copl-labomc/fabconcept/Fiber_Drawing_Tower/Electronics/fiber_electronics_reference_1.jpg

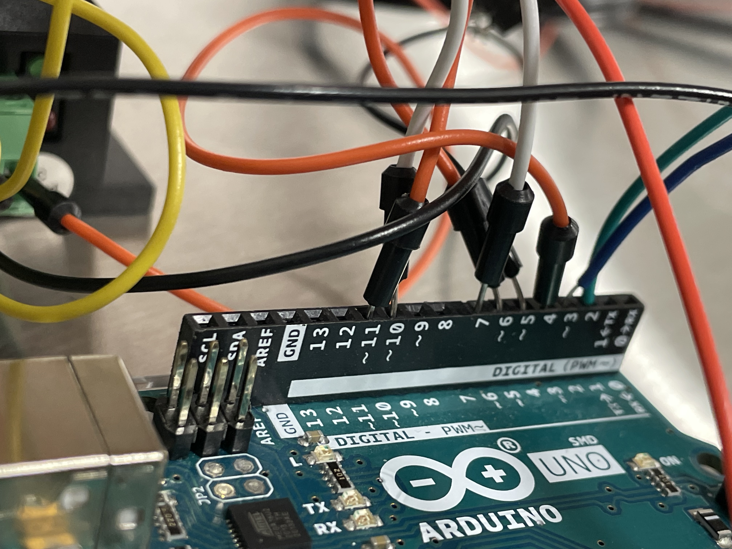
Fiber_Drawing_Tower/Electronics/fiber_electronics_reference_1.jpg
