copl-labomc/fabconcept/Fiber_Drawing_Tower/Electronics/fiber_electronics_reference_2.jpg

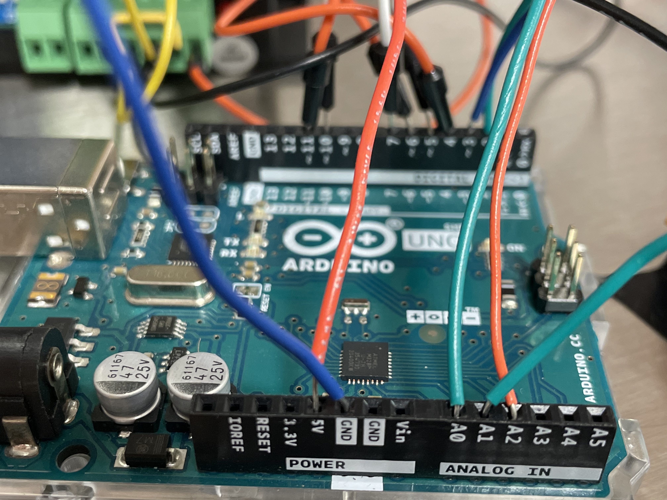
Fiber_Drawing_Tower/Electronics/fiber_electronics_reference_2.jpg
