copl-labomc/fabconcept/README.md

# fabconcept #
Making, modeling and simulating materials doped with nanosemiconductors as well as drawing them into optical fibers.

For more information, see the [wiki](https://github.com/copl-labomc/fabconcept/wiki).
