copl-labomc/fabconcept/Fiber_Drawing_Tower/diagramme_fonctionnel_tour.pptx

Preform stepper motor

Stepper motor driver

Speed command

Capstan stepper motor

Stepper motor driver

Arduino Uno

Spool stepper motor

Stepper motor driver

Laser sensor

Fiber diameter

Config data
Start/Stop commands
Diameter command

Real T°

Laptop
GUI

Motor speeds
Fiber diameter

Furnace

Thermocouple +
PID

T° setpoint
