copl-labomc/fabconcept/Fiber_Drawing_Tower/Archives/Été_2023/Concept_GUI.xlsx

 |  |  |  | Name of the file |  | .txt
 | Graphique |  |  | Speed of motor |  | m/s
 | PID
 |  | Apply | Diameter | Diameter |  | mm
 |  |  |  | Length |  | m
Représentaion imager de la fibre
 |  |  |  |  | Start
Ajuster l'échelle
