copl-labomc/fabconcept/Fiber_Drawing_Tower/Arduino_and_Python_code/Github flowchart for software development.PNG

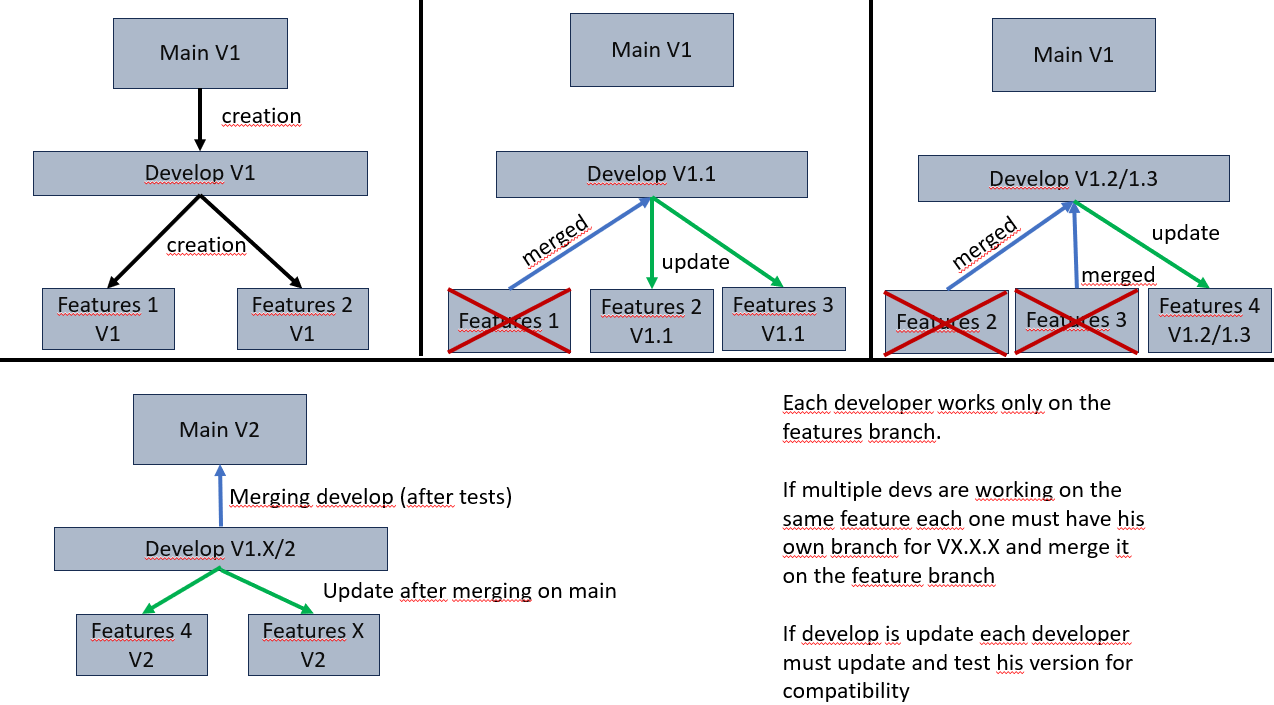
Fiber_Drawing_Tower/Arduino_and_Python_code/Github flowchart for software development.PNG
