copl-labomc/fabconcept/Fiber_Drawing_Tower/Diagramme fonctionnel.png

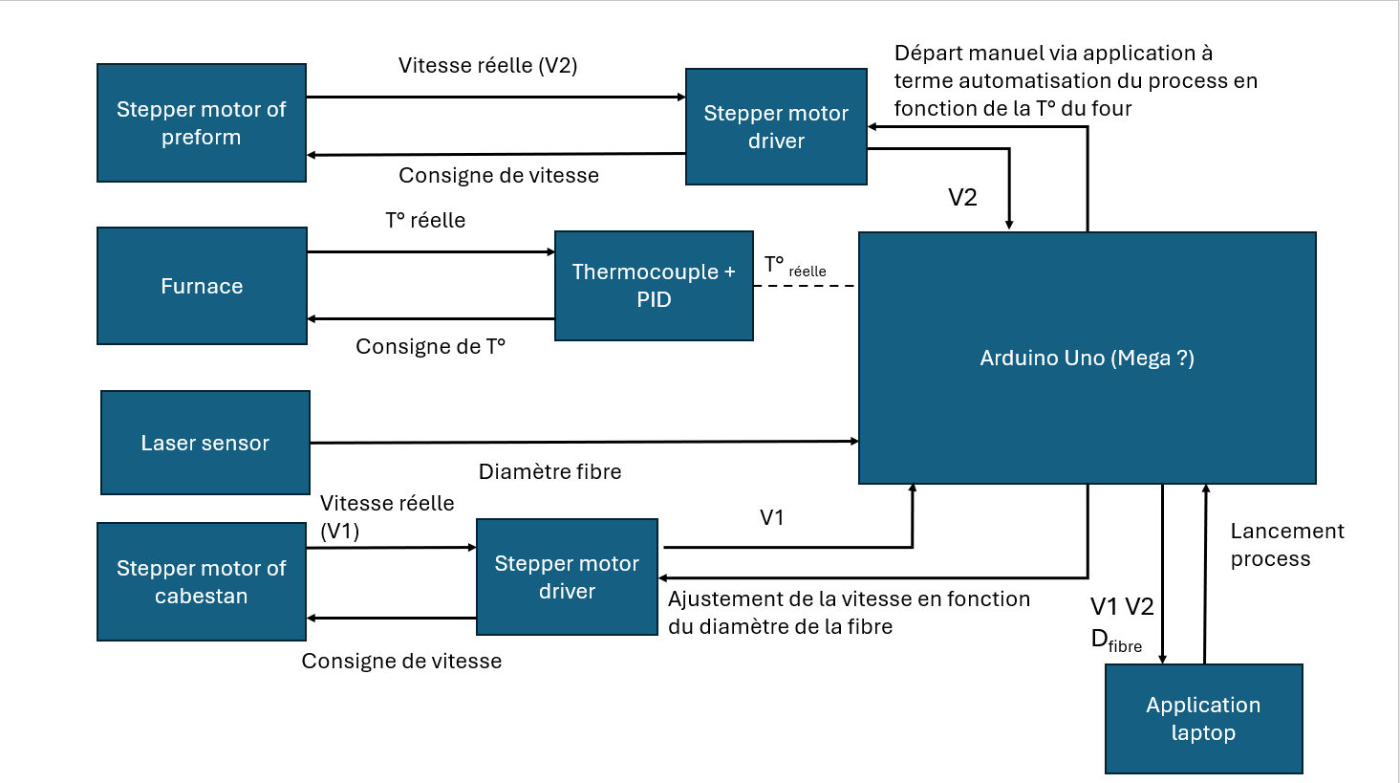
Fiber_Drawing_Tower/Diagramme fonctionnel.png
