copl-labomc/fabconcept/Fiber_Drawing_Tower/Electronics/Fiber_tower_circuit_schéma.png

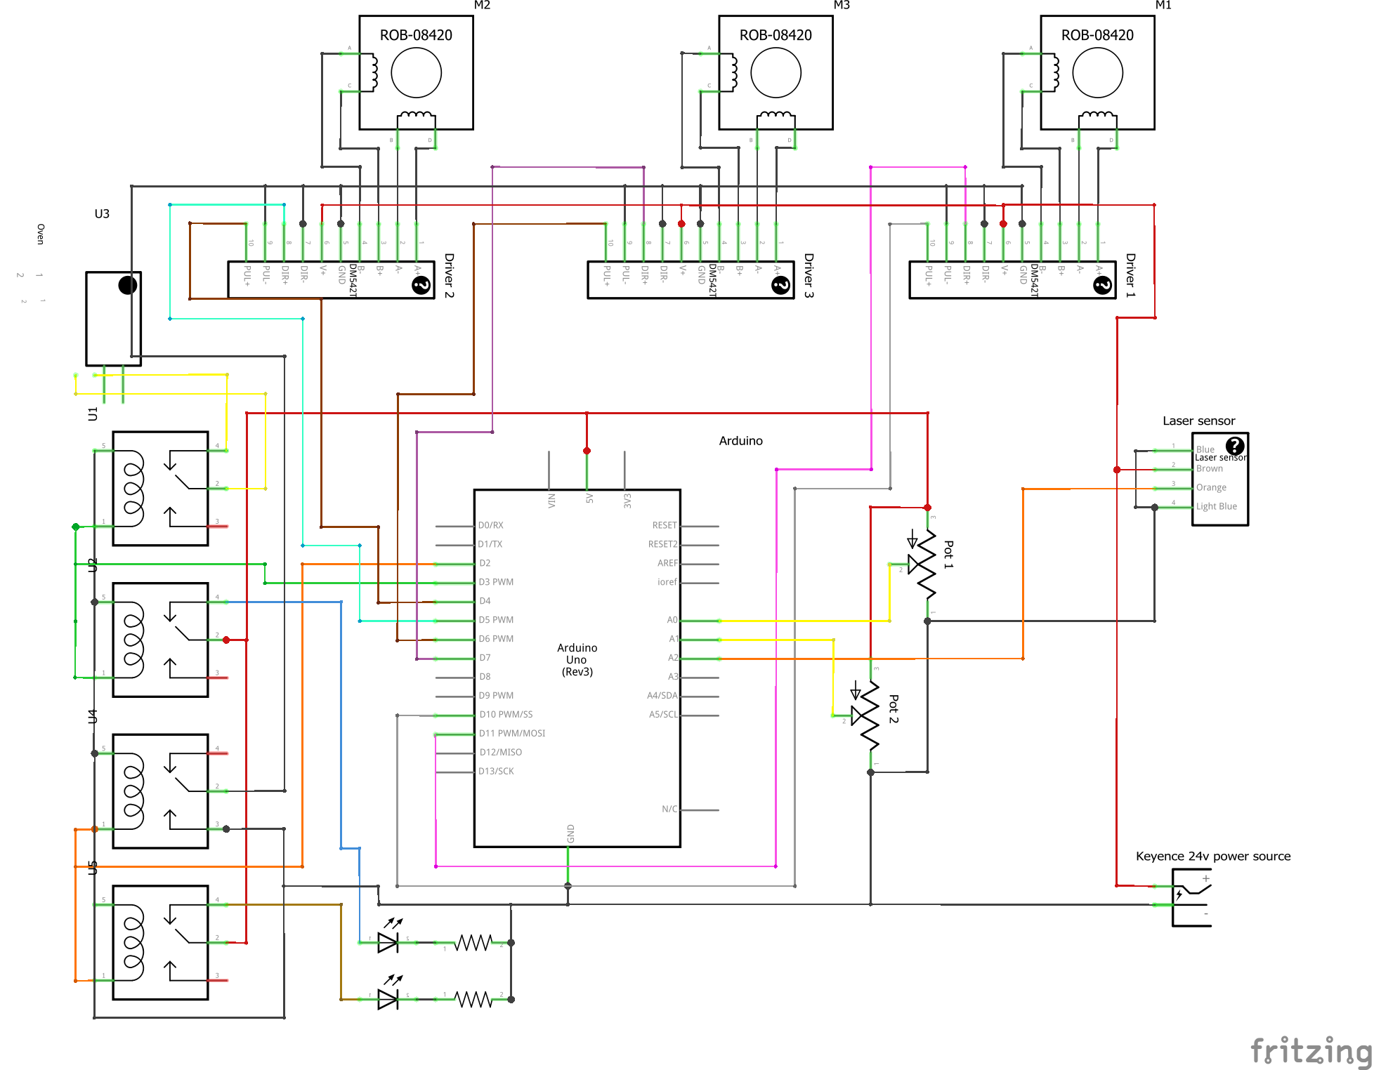
Fiber_Drawing_Tower/Electronics/Fiber_tower_circuit_schéma.png
