copl-labomc/fabconcept/Molecular_Dynamics_Simulations/coordinates.gif

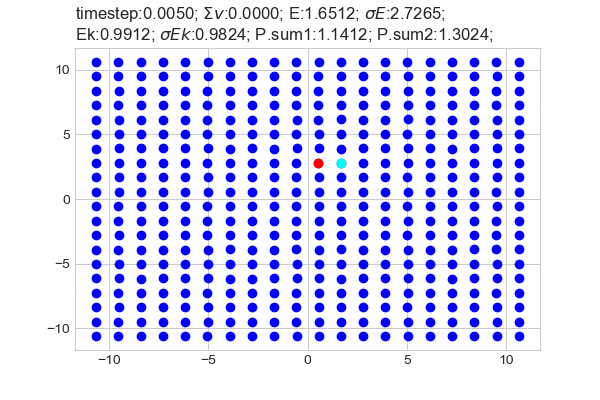
Molecular_Dynamics_Simulations/coordinates.gif
