copl-labomc/fabconcept/Fiber_Drawing_Tower/CAD_sketches/Automatic spool/Current design/Spool_holder.SLDASM

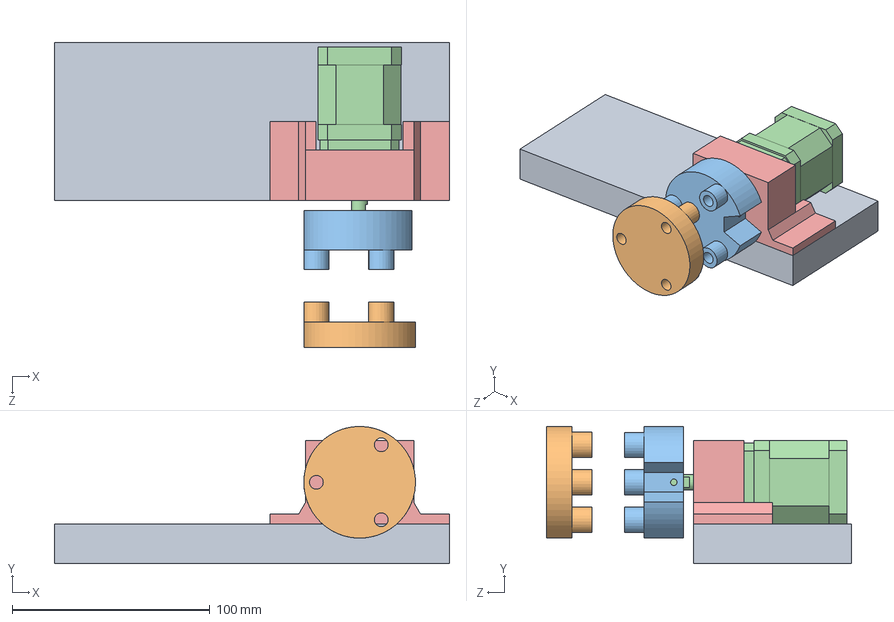
[picture p7: CAD file, 2025-07-08]
Fiber_Drawing_Tower/CAD_sketches/Automatic spool/Current design/Spool_holder.SLDASM
200.0 x 69.4 x 154.5 mm
Fixation_moteur
17HS19-1684S-PG5
coupler_motor_side
coupler_other_side
Spool_support
