copl-labomc/fabconcept/Fiber_Drawing_Tower/CAD_sketches/Preform holder Didn't work/Preform holder.SLDASM

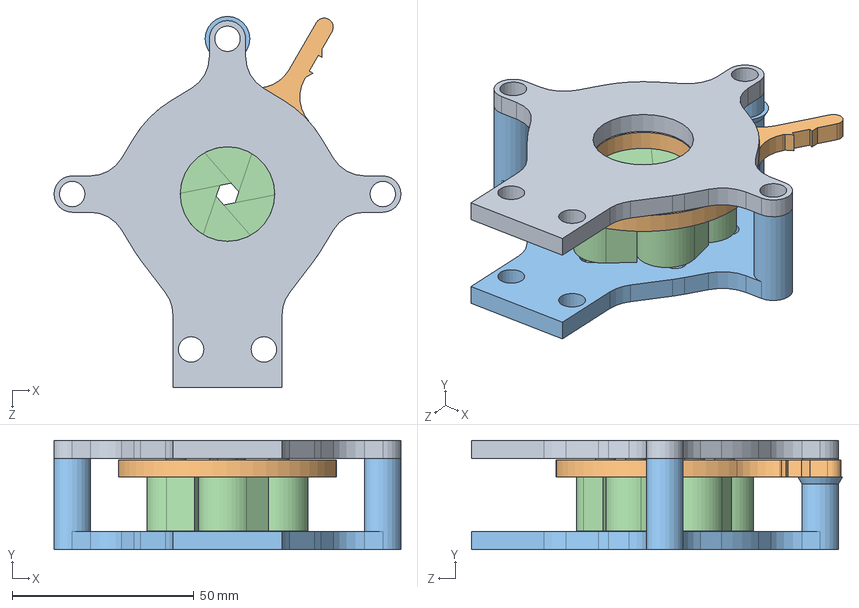
[picture p8: CAD file, 2025-07-08]
Fiber_Drawing_Tower/CAD_sketches/Preform holder Didn't work/Preform holder.SLDASM
95.3 x 30.0 x 102.0 mm
dent x 6
Base 1
Glisseur
Couvercle
