copl-labomc/fabconcept/Fiber_Drawing_Tower/CAD_sketches/Capstan 2.0/Capstan 2.0.SLDASM

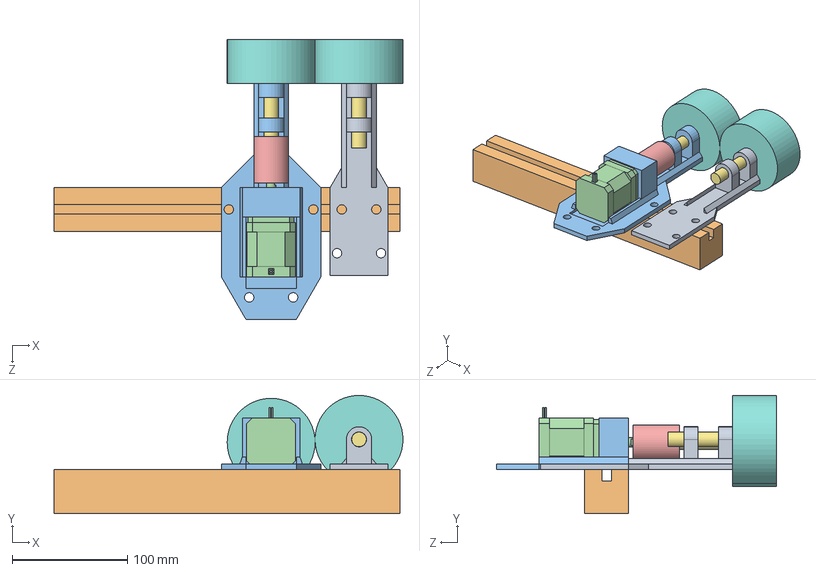
[picture p9: CAD file, 2025-07-08]
Fiber_Drawing_Tower/CAD_sketches/Capstan 2.0/Capstan 2.0.SLDASM
302.4 x 102.3 x 242.4 mm
Wheel x 2
Wheel shaft x 2
Bearing x 4
Motor coupler
17HS19-1684S-PG5
Base motor side
Support beam
Base other side
