copl-labomc/fabconcept/Fiber_Drawing_Tower/CAD_sketches/Preform holder 2 Just a concept/Gripper/Assembly1.stp

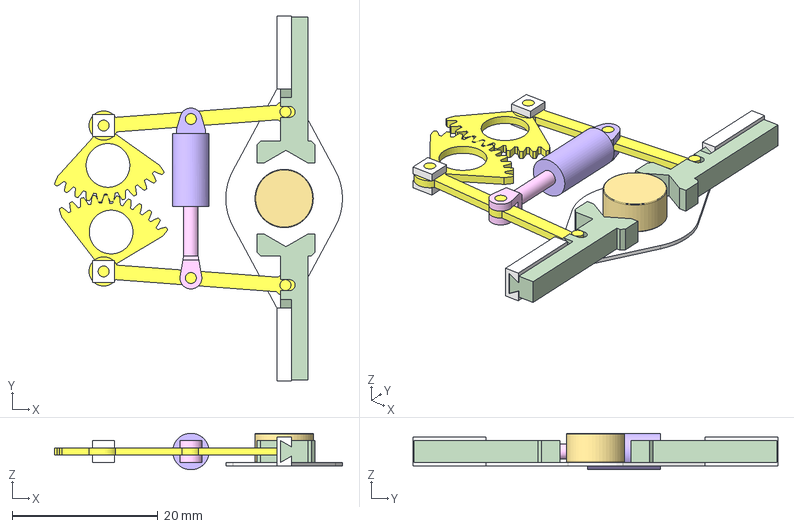
[picture p10: CAD file, 2025-07-08]
Fiber_Drawing_Tower/CAD_sketches/Preform holder 2 Just a concept/Gripper/Assembly1.stp
39.5 x 50.0 x 5.00 mm
Runway
Frame x 2
Jaw1 x 2
CrankA x 2
Gear x 2
Piston
Work
