copl-labomc/fabconcept/Fiber_Drawing_Tower/CAD_sketches/Fiber tower structure (2023)/Assemblage_3d V1.SLDASM

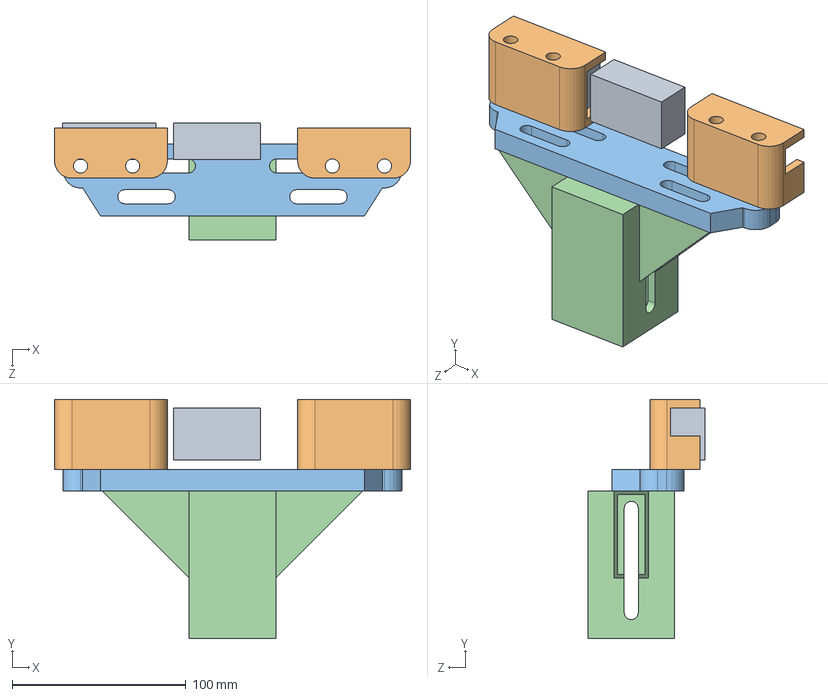
[picture p11: CAD file, 2024-05-07]
Fiber_Drawing_Tower/CAD_sketches/Fiber tower structure (2023)/Assemblage_3d V1.SLDASM
205.0 x 137.8 x 67.6 mm
jauge_diametre
support_jauge x 2
Piece_fixation
bras_jauge
