copl-labomc/fabconcept/Fiber_Drawing_Tower/CAD_sketches/Fiber tower structure (2023)/Assemblage V5.SLDASM

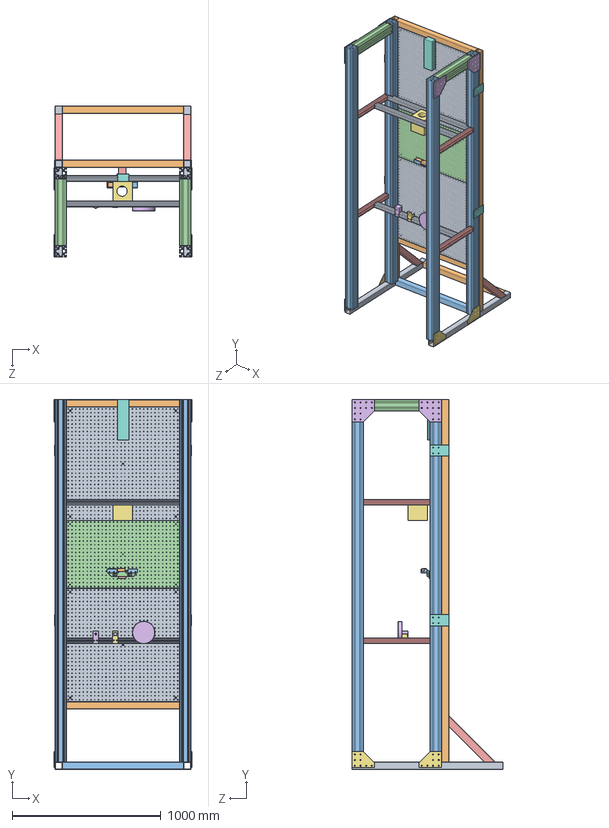
[picture p12: CAD file, 2024-05-07]
Fiber_Drawing_Tower/CAD_sketches/Fiber tower structure (2023)/Assemblage V5.SLDASM
927.1 x 2489.2 x 1016.0 mm
Low-Carbon Steel Tube 40 x 2
Low-Carbon Steel Tube 96 x 2
47065T609_T-Slotted Framing x 4
47065T608_ALUMINUM T-SLOTTED 17.725 x 2
Low-Carbon Steel Tube angle x 2
47065T277_T-Slotted Framing stock x 4
47065T277_T-Slotted Framing x 4
Plaque de fixation x 4
MB30-Solidworks x 2
Low-Carbon Steel Tube 32-1 x 3
Low-Carbon Steel Tube 32
MB1830-Solidworks (1)
47065T942_T-Slotted Framing_30in x 4
Fourneau
Feeder preforme
47065T602_T-Slotted Framing_36in x 3
jauge_diametre
support_jauge x 2
Piece_fixation
bras_jauge
Fixation Roue
Fixation moteur
