copl-labomc/fabconcept/Fiber_Drawing_Tower/CAD_sketches/Capstan 2.0/Bearing.SLDPRT

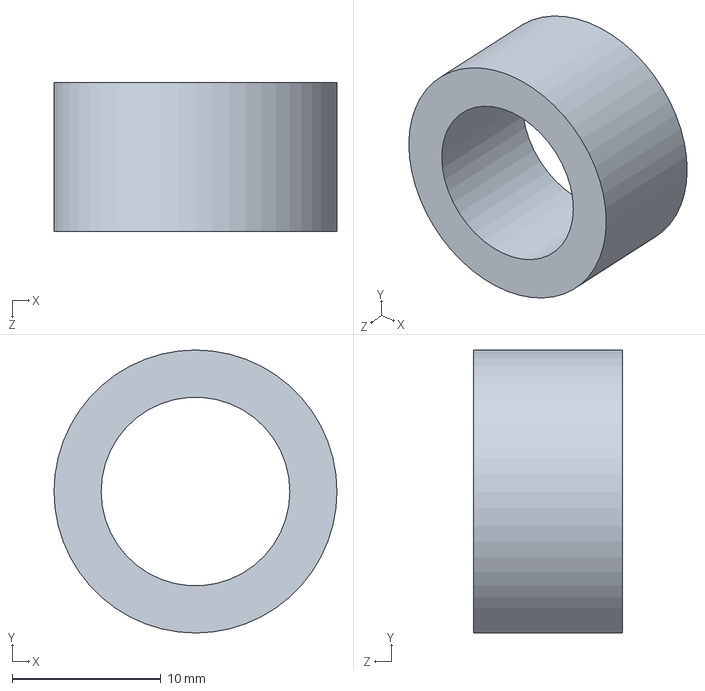
[picture p13: CAD file, 2025-07-08]
Fiber_Drawing_Tower/CAD_sketches/Capstan 2.0/Bearing.SLDPRT
19.1 x 19.1 x 10.0 mm
