copl-labomc/fabconcept/Fiber_Drawing_Tower/CAD_sketches/Fiber tower structure (2023)/Fourneau.SLDPRT

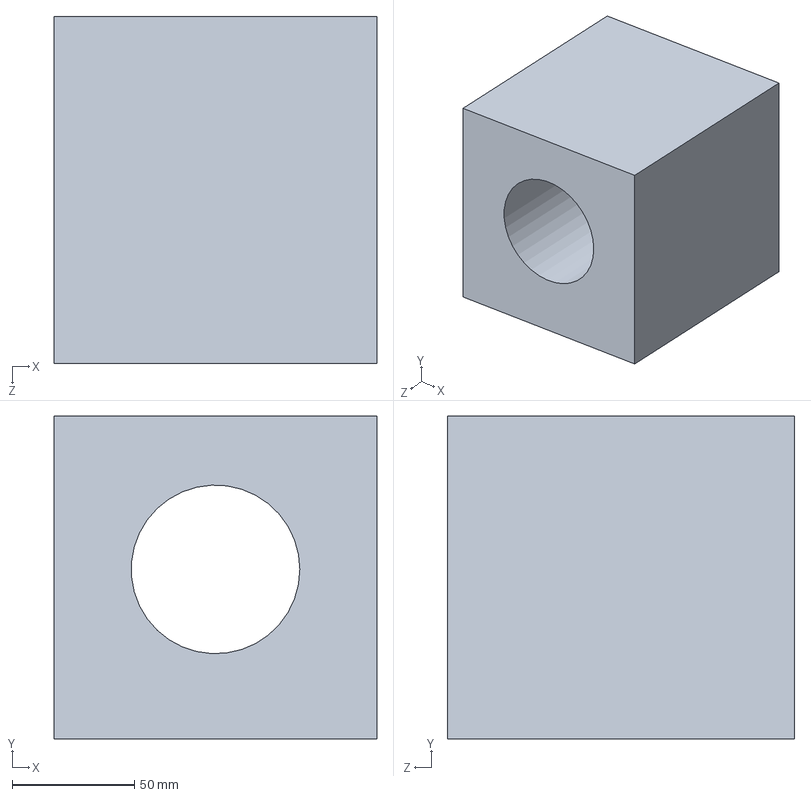
[picture p14: CAD file, 2024-05-07]
Fiber_Drawing_Tower/CAD_sketches/Fiber tower structure (2023)/Fourneau.SLDPRT
132.0 x 132.0 x 142.0 mm
