copl-labomc/fabconcept/Fiber_Drawing_Tower/CAD_sketches/holders laser sensor IG/holder_3D_impression.STL

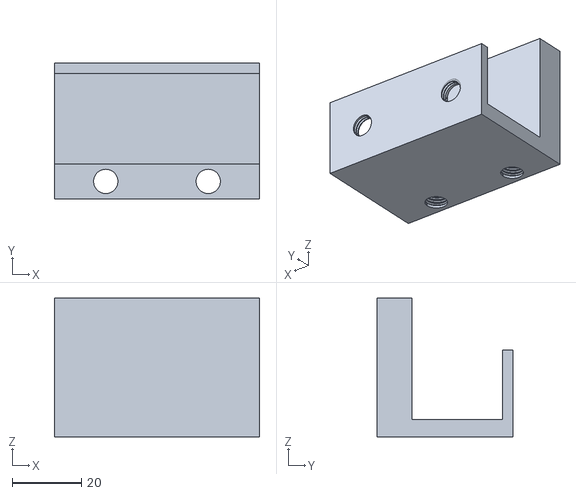
[picture p15: CAD file, 2024-05-31]
Fiber_Drawing_Tower/CAD_sketches/holders laser sensor IG/holder_3D_impression.STL
59.0 x 39.0 x 40.0
