copl-labomc/fabconcept/Fiber_Drawing_Tower/CAD_sketches/Preform holder 2 Just a concept/Gripper/Bearing.stp

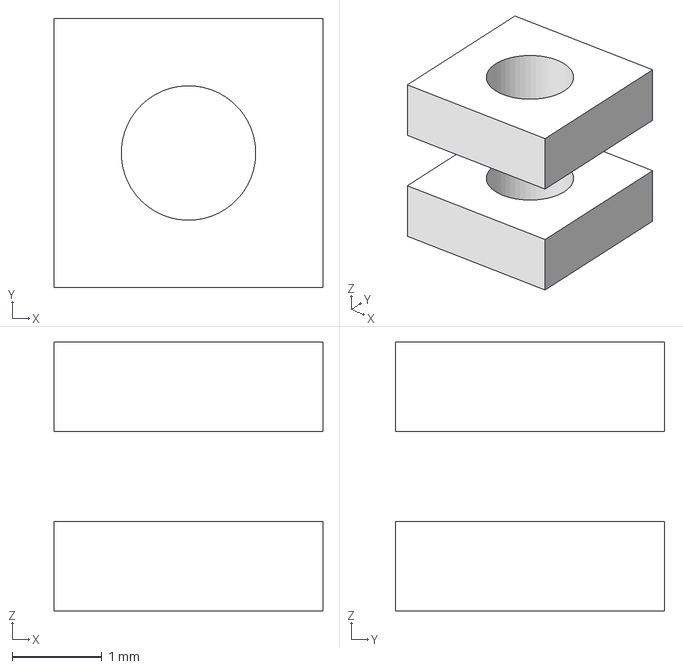
[picture p16: CAD file, 2025-07-08]
Fiber_Drawing_Tower/CAD_sketches/Preform holder 2 Just a concept/Gripper/Bearing.stp
3.00 x 3.00 x 3.00 mm
