copl-labomc/fabconcept/Fiber_Drawing_Tower/CAD_sketches/Preform holder 2 Just a concept/Newport variable lens holder/Newport-LCM-1.stp

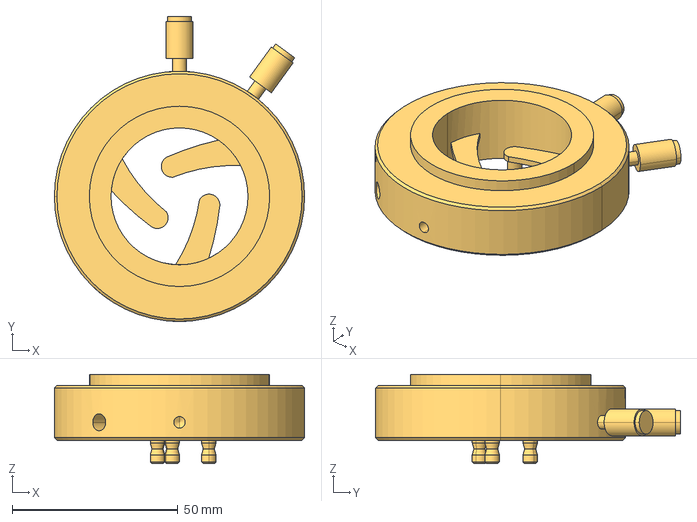
[picture p17: CAD file, 2025-07-08]
Fiber_Drawing_Tower/CAD_sketches/Preform holder 2 Just a concept/Newport variable lens holder/Newport-LCM-1.stp
75.4 x 91.9 x 26.9 mm
