copl-labomc/fabconcept/Fiber_Drawing_Tower/CAD_sketches/Preform holder 3.0 unfinished/Holder holder.SLDPRT

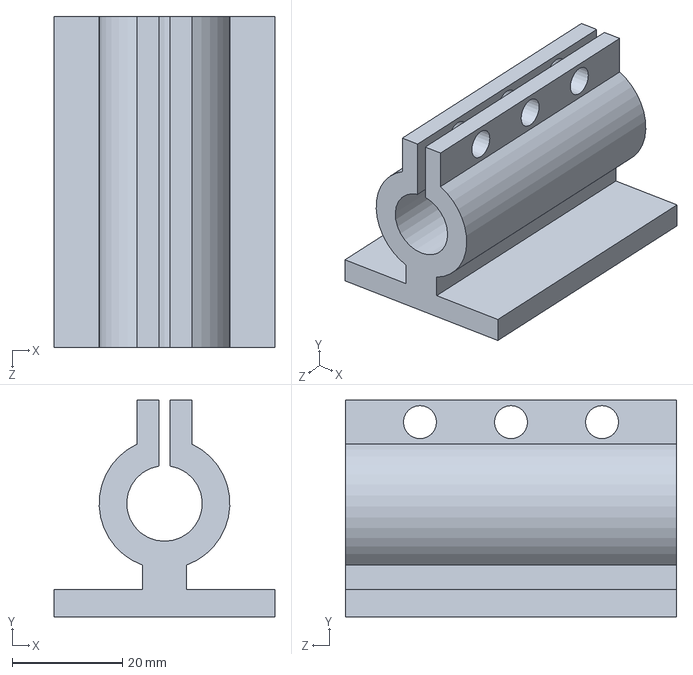
[picture p18: CAD file, 2025-07-08]
Fiber_Drawing_Tower/CAD_sketches/Preform holder 3.0 unfinished/Holder holder.SLDPRT
40.0 x 39.3 x 60.0 mm
