copl-labomc/fabconcept/Fiber_Drawing_Tower/CAD_sketches/Preform holder Didn't work/Base.STL

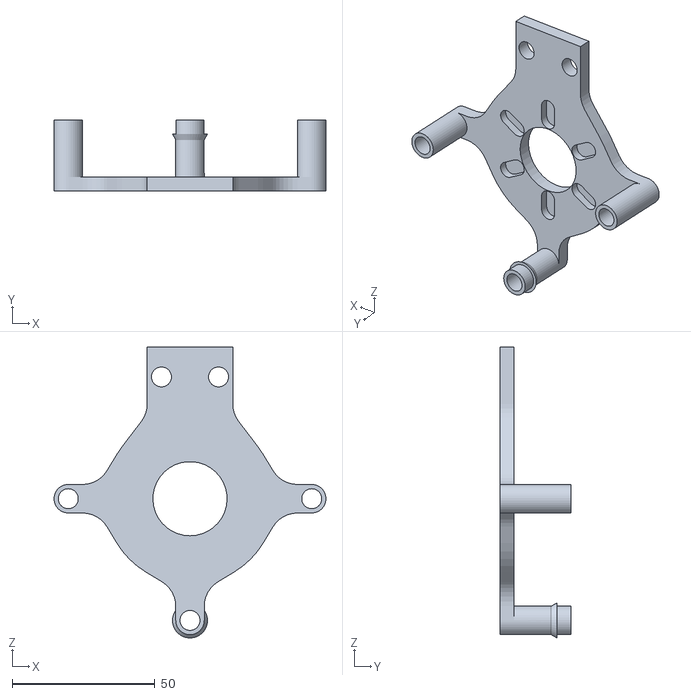
[picture p19: CAD file, 2025-07-08]
Fiber_Drawing_Tower/CAD_sketches/Preform holder Didn't work/Base.STL
95.3 x 25.0 x 102.0
