copl-labomc/fabconcept/Fiber_Drawing_Tower/CAD_sketches/Automatic spool/Current design/coupler_motor_side.SLDPRT

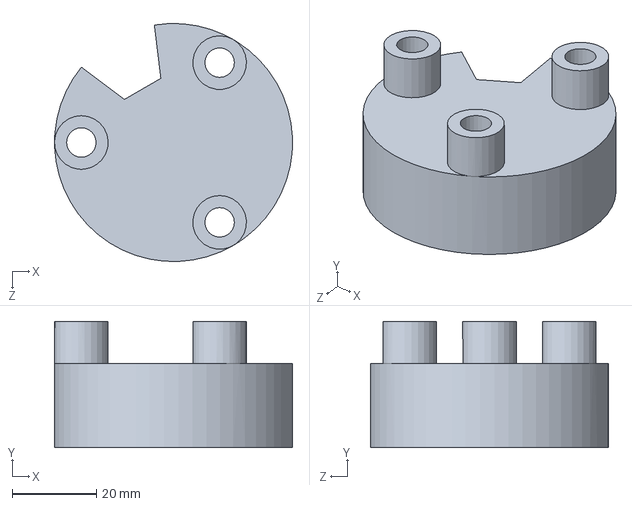
[picture p20: CAD file, 2025-07-08]
Fiber_Drawing_Tower/CAD_sketches/Automatic spool/Current design/coupler_motor_side.SLDPRT
56.5 x 30.0 x 56.5 mm
