copl-labomc/fabconcept/Fiber_Drawing_Tower/CAD_sketches/Capstan 2.0/Base 1.STL

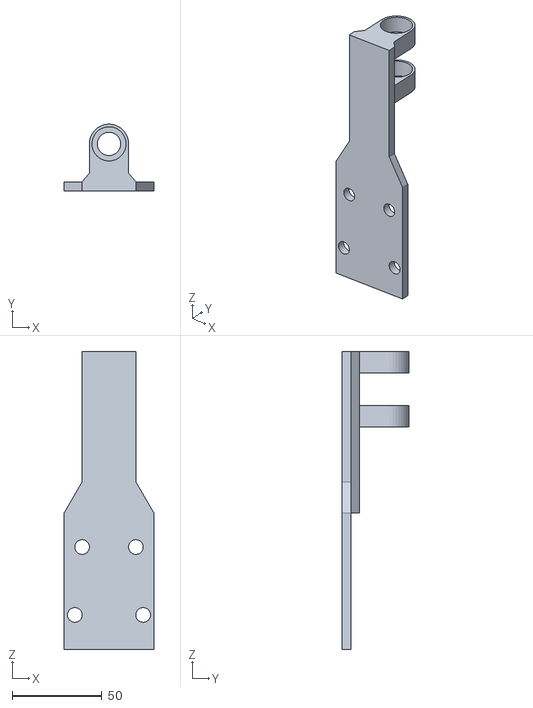
[picture p21: CAD file, 2025-07-08]
Fiber_Drawing_Tower/CAD_sketches/Capstan 2.0/Base 1.STL
50.0 x 37.1 x 166.2
