copl-labomc/fabconcept/Fiber_Drawing_Tower/CAD_sketches/Fiber tower structure (2023)/Feeder preforme.SLDPRT

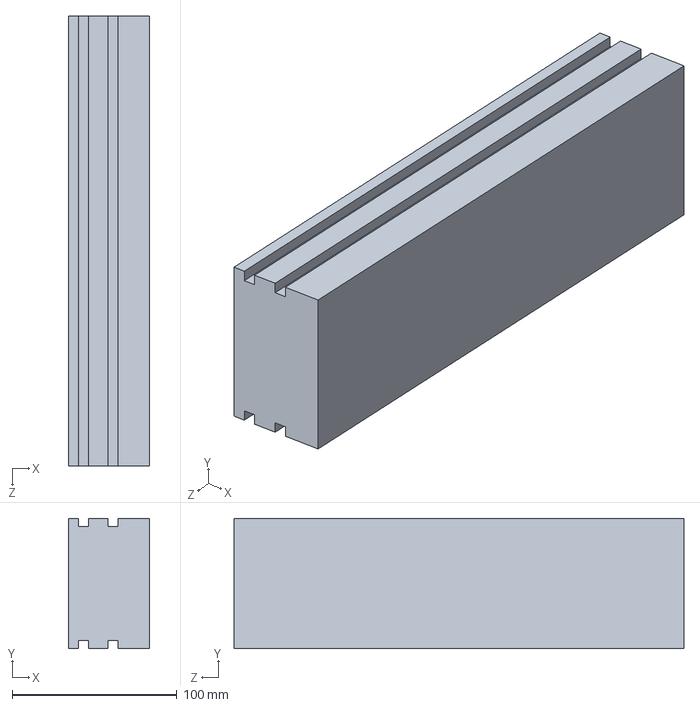
[picture p22: CAD file, 2024-05-07]
Fiber_Drawing_Tower/CAD_sketches/Fiber tower structure (2023)/Feeder preforme.SLDPRT
49.0 x 79.0 x 273.0 mm
