copl-labomc/fabconcept/Fiber_Drawing_Tower/CAD_sketches/Preform holder 2 Just a concept/Gripper/Gear.stp

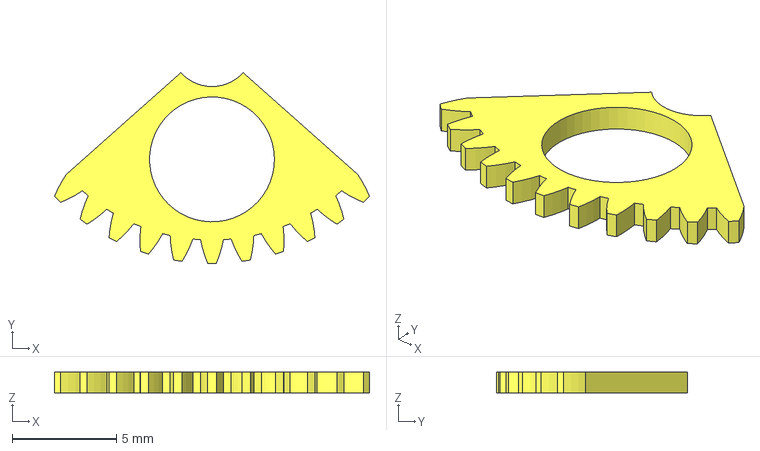
[picture p23: CAD file, 2025-07-08]
Fiber_Drawing_Tower/CAD_sketches/Preform holder 2 Just a concept/Gripper/Gear.stp
15.1 x 9.17 x 1.00 mm
