copl-labomc/fabconcept/Fiber_Drawing_Tower/CAD_sketches/Automatic spool/Current design/Spool_support.SLDPRT

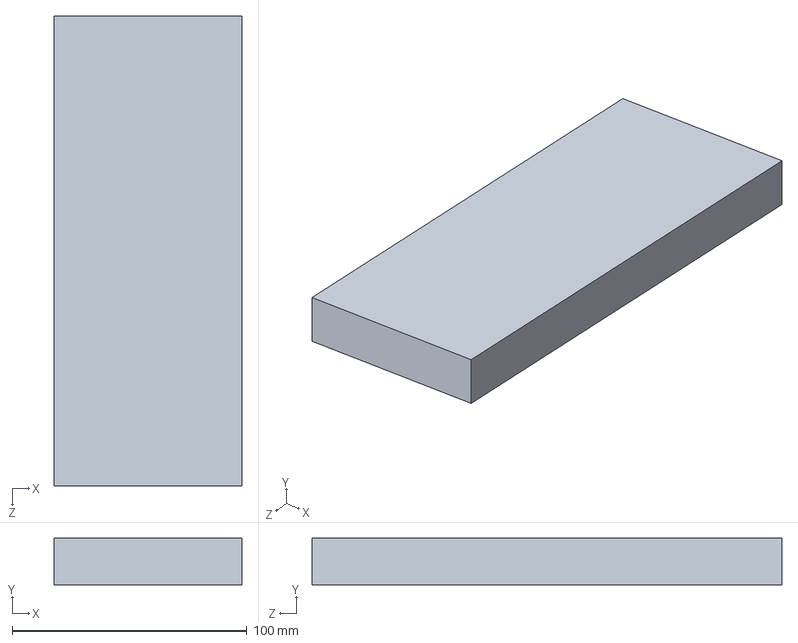
[picture p24: CAD file, 2025-07-08]
Fiber_Drawing_Tower/CAD_sketches/Automatic spool/Current design/Spool_support.SLDPRT
80.0 x 20.0 x 200.0 mm
