copl-labomc/fabconcept/Fiber_Drawing_Tower/CAD_sketches/Capstan 2.0/Base 2.STL

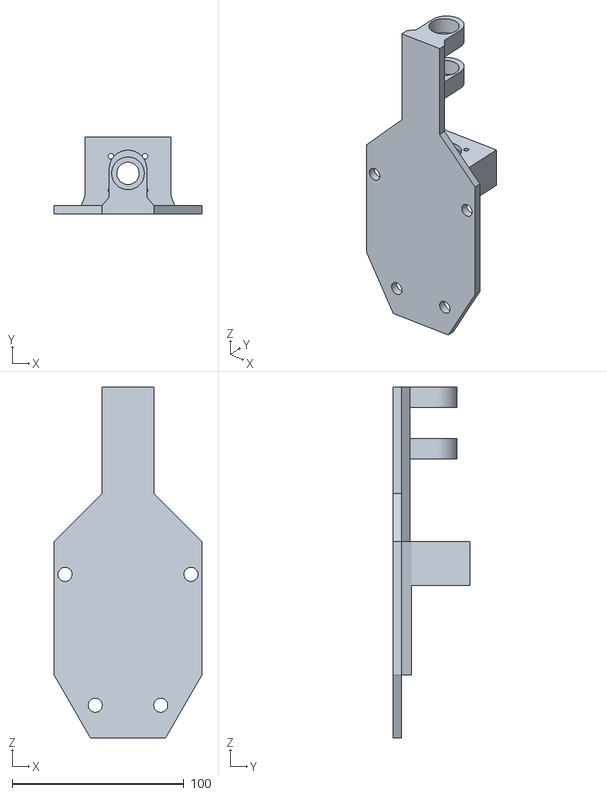
[picture p25: CAD file, 2025-07-08]
Fiber_Drawing_Tower/CAD_sketches/Capstan 2.0/Base 2.STL
86.0 x 44.8 x 204.3
