copl-labomc/fabconcept/Fiber_Drawing_Tower/CAD_sketches/Fiber tower structure (2023)/Pièce28.SLDPRT

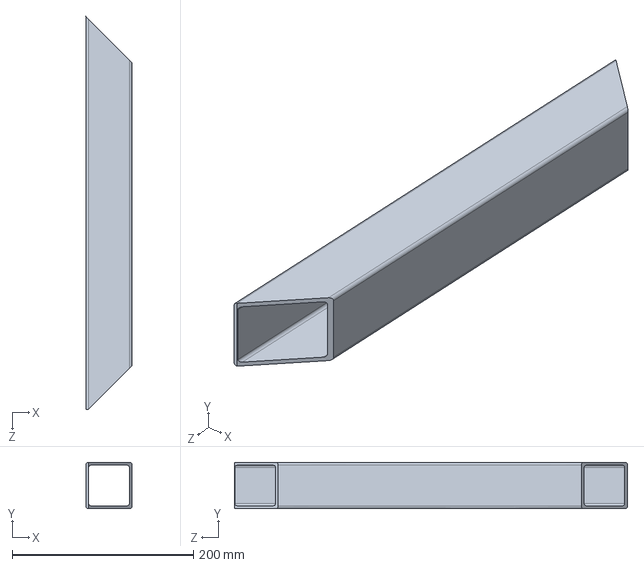
[picture p26: CAD file, 2024-05-07]
Fiber_Drawing_Tower/CAD_sketches/Fiber tower structure (2023)/Pièce28.SLDPRT
50.8 x 50.8 x 433.6 mm
