copl-labomc/fabconcept/Fiber_Drawing_Tower/CAD_sketches/Preform holder 2 Just a concept/Gripper/Jaw1.stp

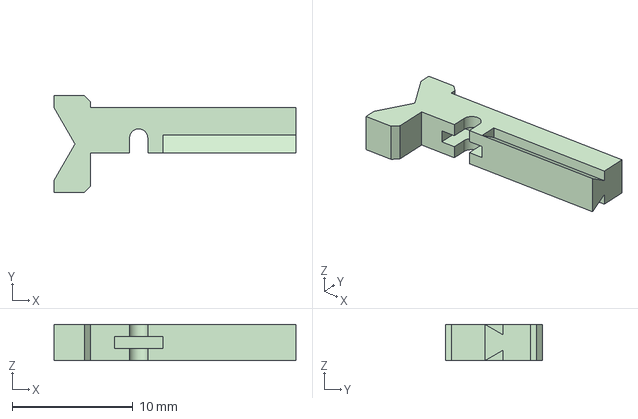
[picture p27: CAD file, 2025-07-08]
Fiber_Drawing_Tower/CAD_sketches/Preform holder 2 Just a concept/Gripper/Jaw1.stp
20.0 x 8.00 x 3.00 mm
