copl-labomc/fabconcept/Fiber_Drawing_Tower/CAD_sketches/Automatic spool/Current design/coupleur 2.STL

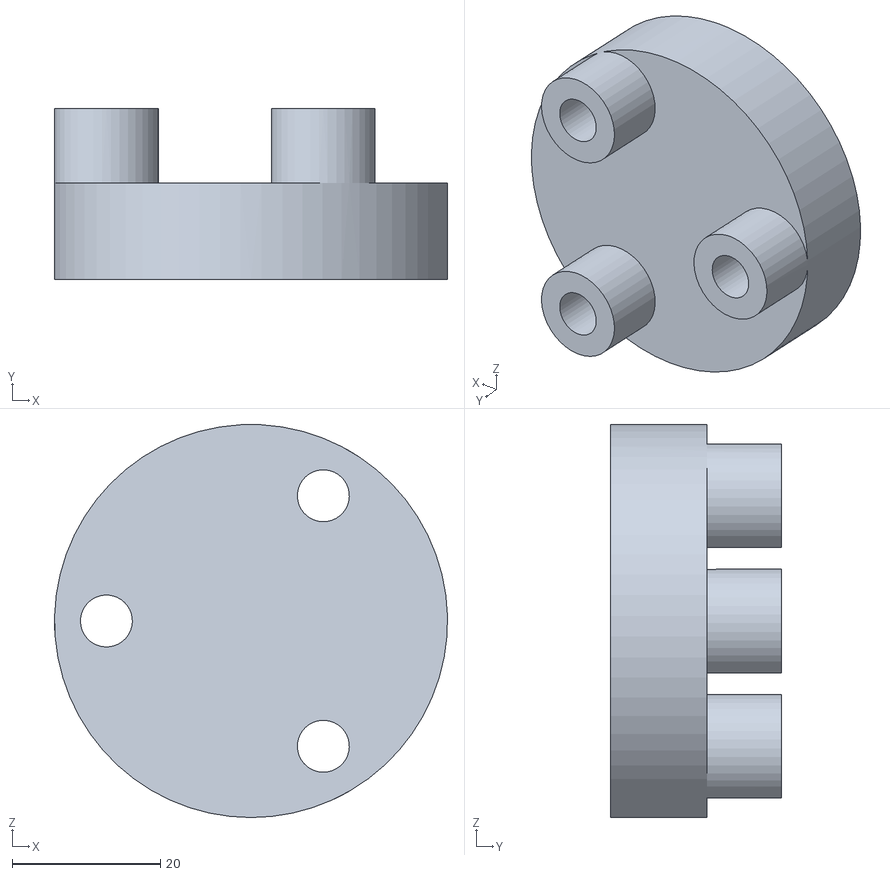
[picture p28: CAD file, 2025-07-08]
Fiber_Drawing_Tower/CAD_sketches/Automatic spool/Current design/coupleur 2.STL
53.0 x 23.0 x 53.0
