copl-labomc/fabconcept/Fiber_Drawing_Tower/CAD_sketches/Preform holder 2 Just a concept/Gripper/Runway.stp

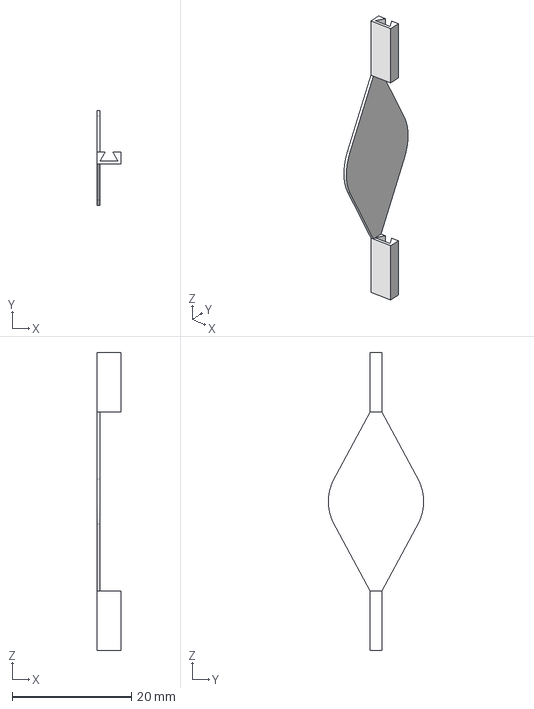
[picture p29: CAD file, 2025-07-08]
Fiber_Drawing_Tower/CAD_sketches/Preform holder 2 Just a concept/Gripper/Runway.stp
4.00 x 16.0 x 50.0 mm
