copl-labomc/fabconcept/Fiber_Drawing_Tower/CAD_sketches/Preform holder Didn't work/Glisseur.SLDPRT

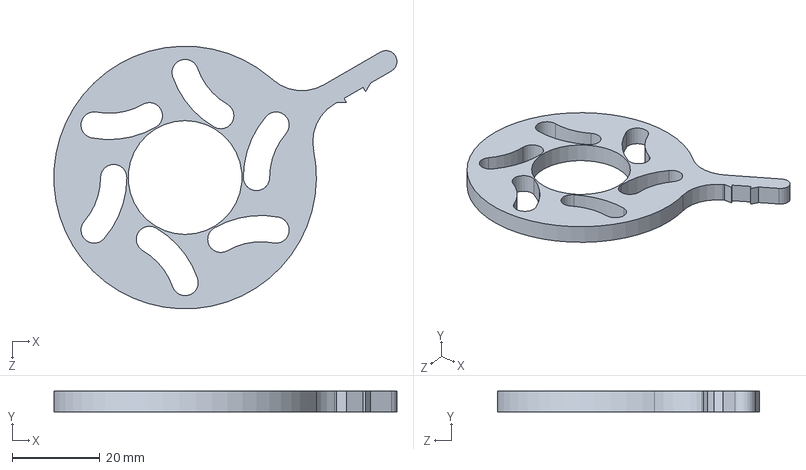
[picture p30: CAD file, 2025-07-08]
Fiber_Drawing_Tower/CAD_sketches/Preform holder Didn't work/Glisseur.SLDPRT
78.4 x 4.75 x 60.0 mm
