copl-labomc/fabconcept/Fiber_Drawing_Tower/CAD_sketches/Automatic spool/Current design/coupleur 1.STL

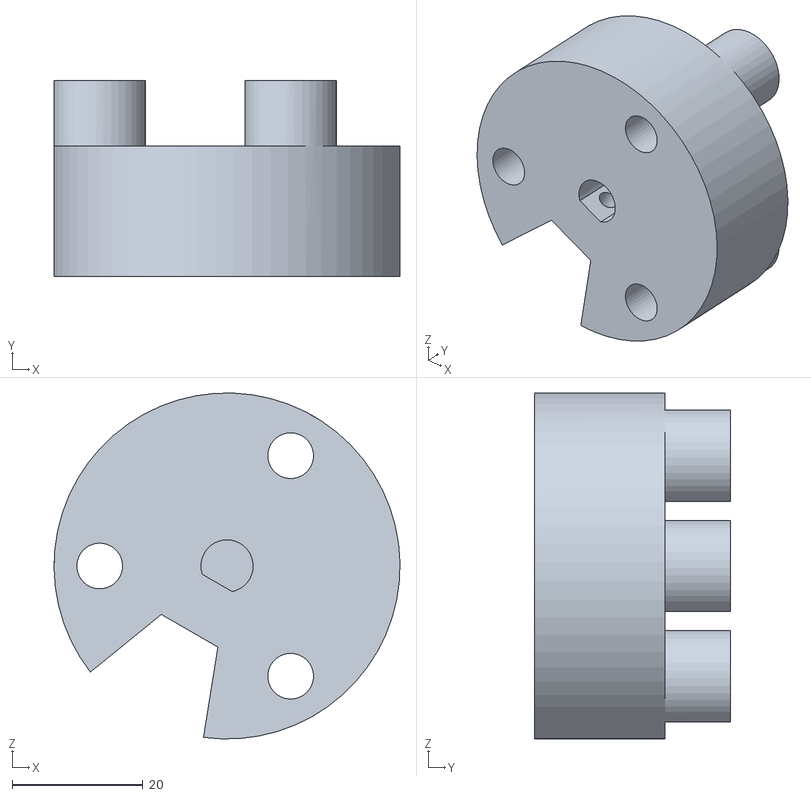
[picture p31: CAD file, 2025-07-08]
Fiber_Drawing_Tower/CAD_sketches/Automatic spool/Current design/coupleur 1.STL
53.0 x 30.0 x 53.0
