copl-labomc/fabconcept/Fiber_Drawing_Tower/CAD_sketches/Fiber tower structure (2023)/support_jauge.SLDPRT

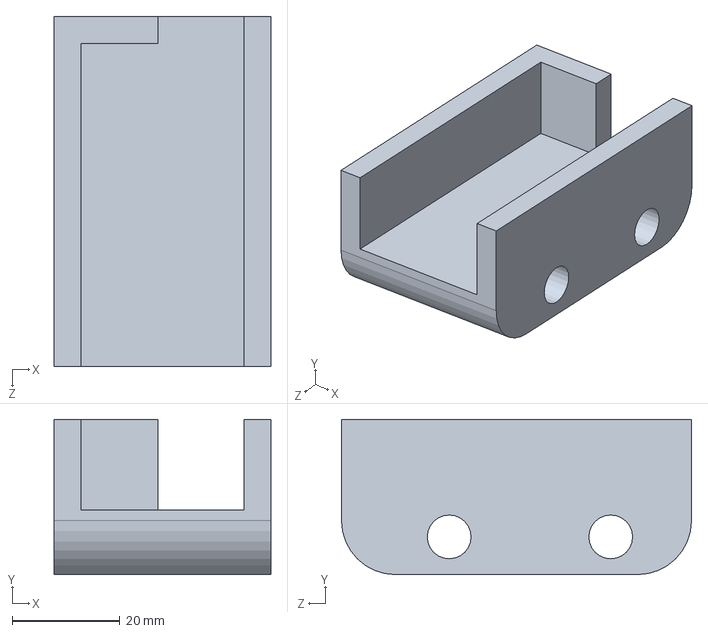
[picture p32: CAD file, 2024-05-07]
Fiber_Drawing_Tower/CAD_sketches/Fiber tower structure (2023)/support_jauge.SLDPRT
40.3 x 28.8 x 65.0 mm
