copl-labomc/fabconcept/Fiber_Drawing_Tower/CAD_sketches/Automatic spool/Current design/coupler_other_side.SLDPRT

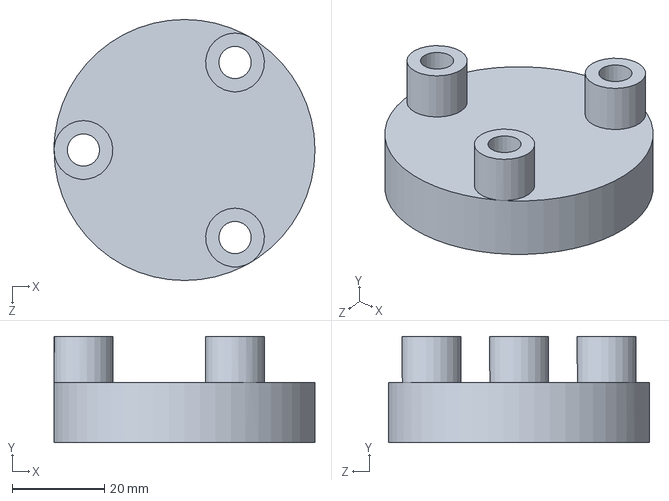
[picture p35: CAD file, 2025-07-08]
Fiber_Drawing_Tower/CAD_sketches/Automatic spool/Current design/coupler_other_side.SLDPRT
56.5 x 23.0 x 56.5 mm
