copl-labomc/fabconcept/Fiber_Drawing_Tower/CAD_sketches/Capstan 2.0/17HS19-1684S-PG5.SLDPRT

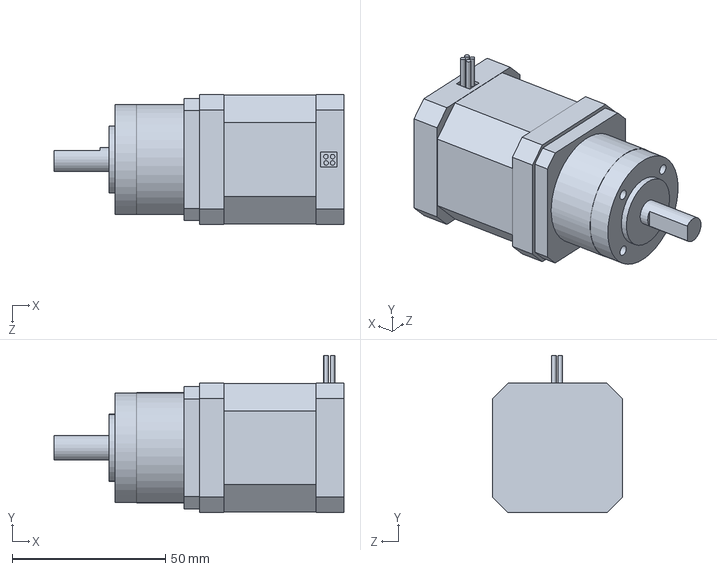
[picture p36: CAD file, 2025-07-08]
Fiber_Drawing_Tower/CAD_sketches/Capstan 2.0/17HS19-1684S-PG5.SLDPRT
94.7 x 51.3 x 42.3 mm
