copl-labomc/fabconcept/Fiber_Drawing_Tower/CAD_sketches/holders laser sensor IG/TS25H-Solidworks.SLDPRT

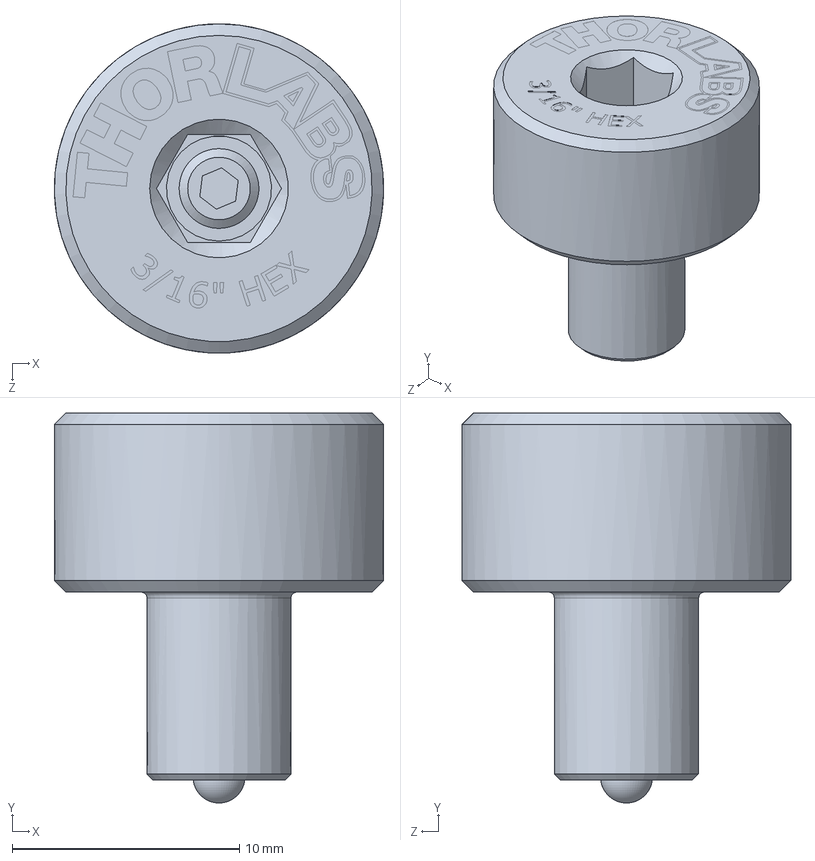
[picture p37: CAD file, 2024-05-07]
Fiber_Drawing_Tower/CAD_sketches/holders laser sensor IG/TS25H-Solidworks.SLDPRT
14.5 x 17.1 x 14.5 mm
