copl-labomc/fabconcept/Fiber_Drawing_Tower/CAD_sketches/Preform holder Didn't work/dent.SLDPRT

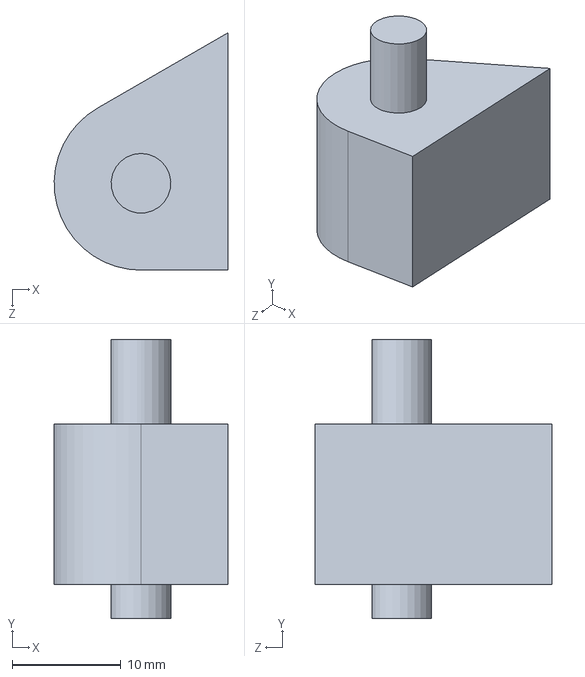
[picture p38: CAD file, 2025-07-08]
Fiber_Drawing_Tower/CAD_sketches/Preform holder Didn't work/dent.SLDPRT
16.0 x 25.7 x 21.9 mm
