copl-labomc/fabconcept/Fiber_Drawing_Tower/CAD_sketches/Automatic spool/Current design/Fixation_moteur.SLDPRT

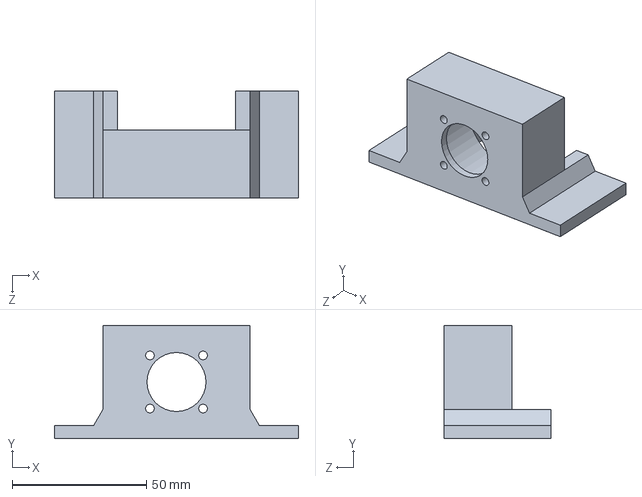
[picture p39: CAD file, 2025-07-08]
Fiber_Drawing_Tower/CAD_sketches/Automatic spool/Current design/Fixation_moteur.SLDPRT
91.0 x 42.3 x 40.0 mm
