copl-labomc/fabconcept/Fiber_Drawing_Tower/CAD_sketches/Fiber tower structure (2023)/Moteur.SLDPRT

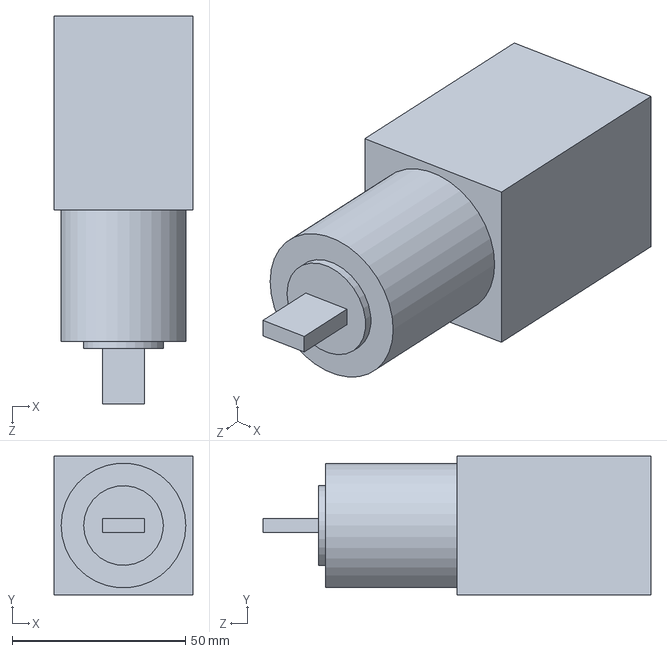
[picture p40: CAD file, 2024-05-07]
Fiber_Drawing_Tower/CAD_sketches/Fiber tower structure (2023)/Moteur.SLDPRT
40.0 x 40.0 x 112.0 mm
