copl-labomc/fabconcept/Fiber_Drawing_Tower/CAD_sketches/Preform holder Didn't work/Couvercle.SLDPRT

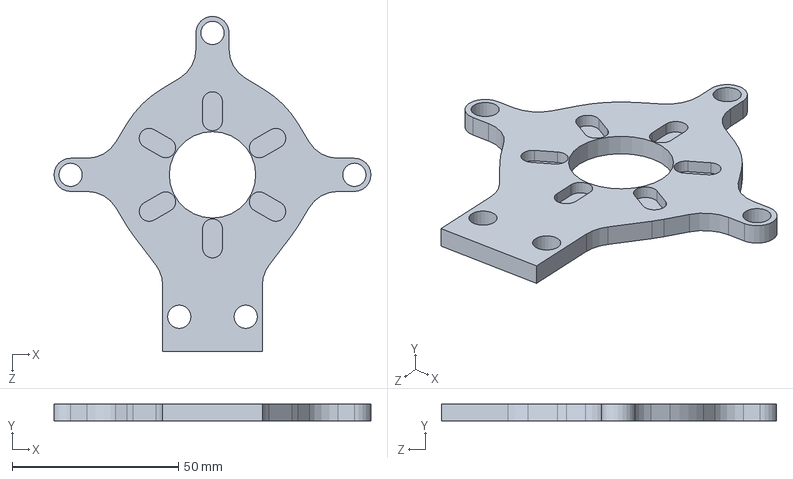
[picture p42: CAD file, 2025-07-08]
Fiber_Drawing_Tower/CAD_sketches/Preform holder Didn't work/Couvercle.SLDPRT
95.3 x 5.00 x 100.9 mm
