copl-labomc/fabconcept/Fiber_Drawing_Tower/CAD_sketches/Capstan 2.0/Motor coupler.SLDPRT

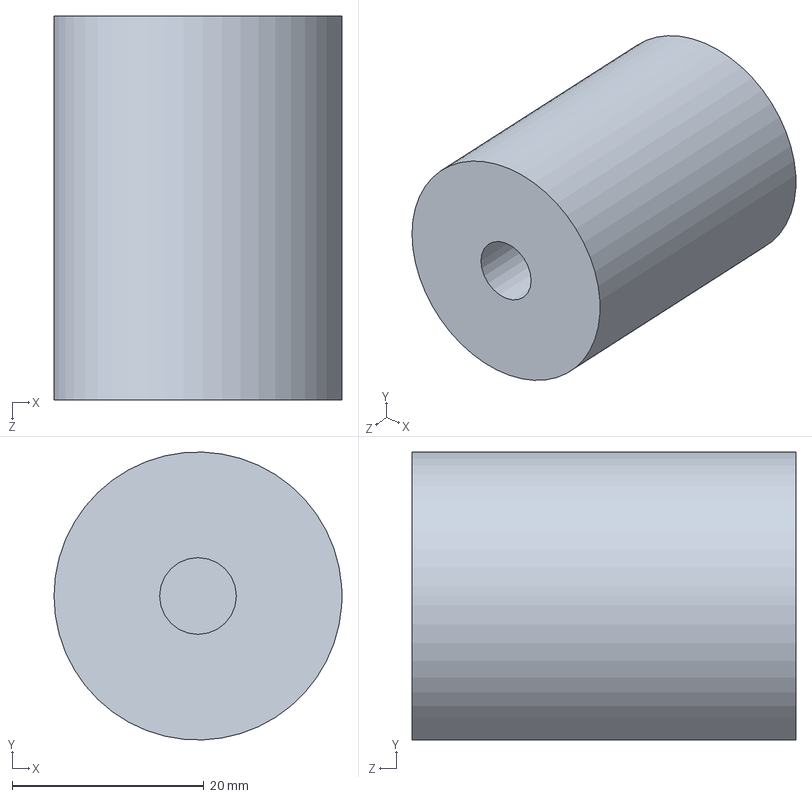
[picture p43: CAD file, 2025-07-08]
Fiber_Drawing_Tower/CAD_sketches/Capstan 2.0/Motor coupler.SLDPRT
30.0 x 30.0 x 40.0 mm
