copl-labomc/fabconcept/Fiber_Drawing_Tower/CAD_sketches/Fiber tower structure (2023)/Pièce30.SLDPRT

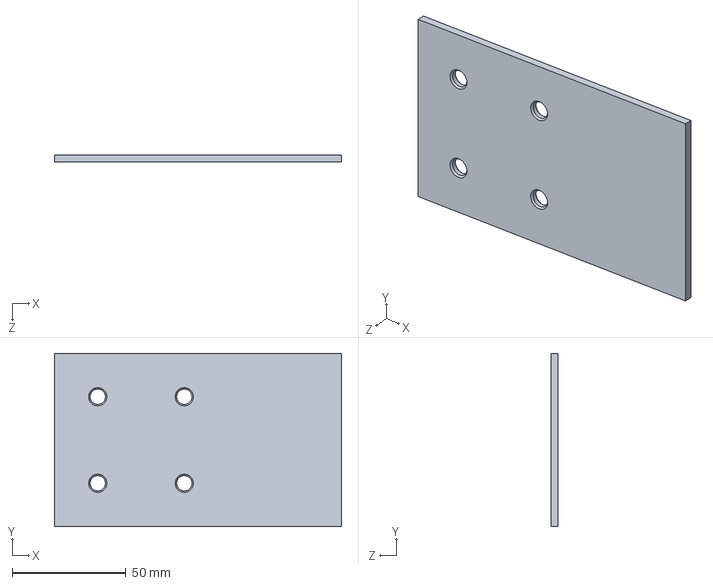
[picture p44: CAD file, 2024-05-07]
Fiber_Drawing_Tower/CAD_sketches/Fiber tower structure (2023)/Pièce30.SLDPRT
126.4 x 76.2 x 3.17 mm
