copl-labomc/fabconcept/Fiber_Drawing_Tower/CAD_sketches/Fiber tower structure (2023)/jauge_diametre.SLDPRT

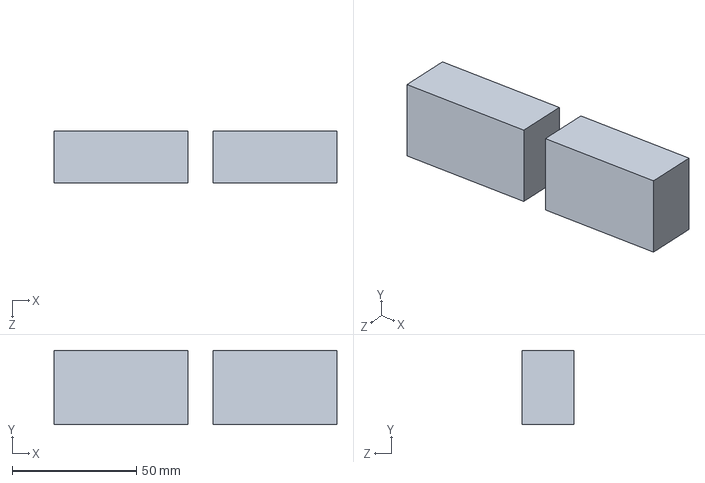
[picture p46: CAD file, 2024-05-07]
Fiber_Drawing_Tower/CAD_sketches/Fiber tower structure (2023)/jauge_diametre.SLDPRT
114.0 x 30.0 x 21.0 mm
