copl-labomc/fabconcept/Fiber_Drawing_Tower/CAD_sketches/Capstan 2.0/Support beam.SLDPRT

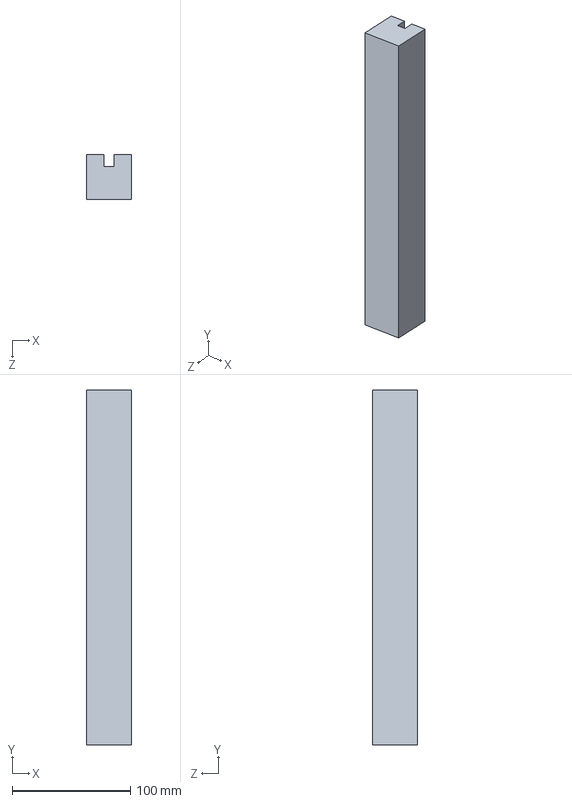
[picture p48: CAD file, 2025-07-08]
Fiber_Drawing_Tower/CAD_sketches/Capstan 2.0/Support beam.SLDPRT
38.1 x 300.0 x 38.1 mm
