copl-labomc/fabconcept/Fiber_Drawing_Tower/CAD_sketches/Capstan 2.0/Wheel.SLDPRT

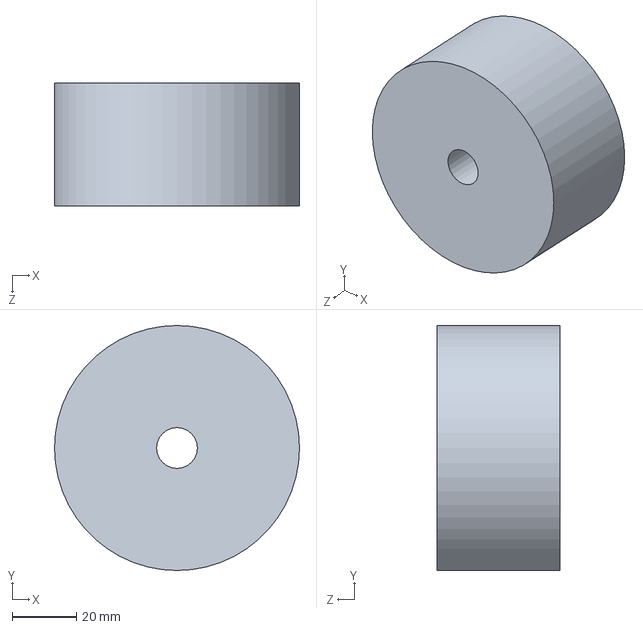
[picture p49: CAD file, 2025-07-08]
Fiber_Drawing_Tower/CAD_sketches/Capstan 2.0/Wheel.SLDPRT
76.2 x 76.2 x 38.1 mm
