copl-labomc/fabconcept/Fiber_Drawing_Tower/CAD_sketches/Fiber tower structure (2023)/Fixation moteur.SLDPRT

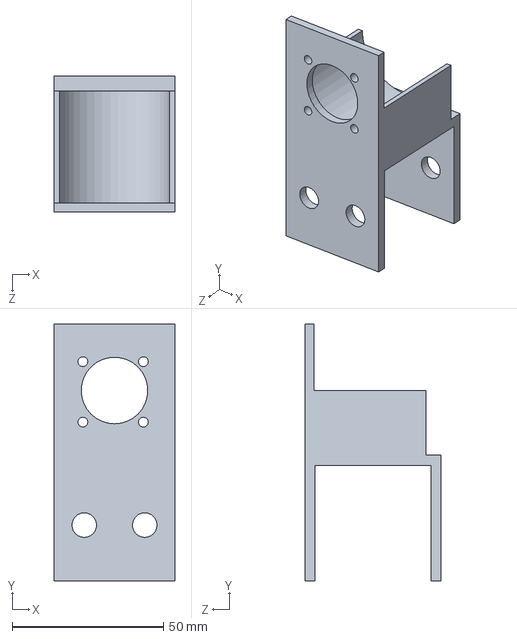
[picture p50: CAD file, 2024-05-07]
Fiber_Drawing_Tower/CAD_sketches/Fiber tower structure (2023)/Fixation moteur.SLDPRT
40.0 x 85.0 x 45.0 mm
