copl-labomc/fabconcept/Fiber_Drawing_Tower/CAD_sketches/Capstan 2.0/Wheel shaft.SLDPRT

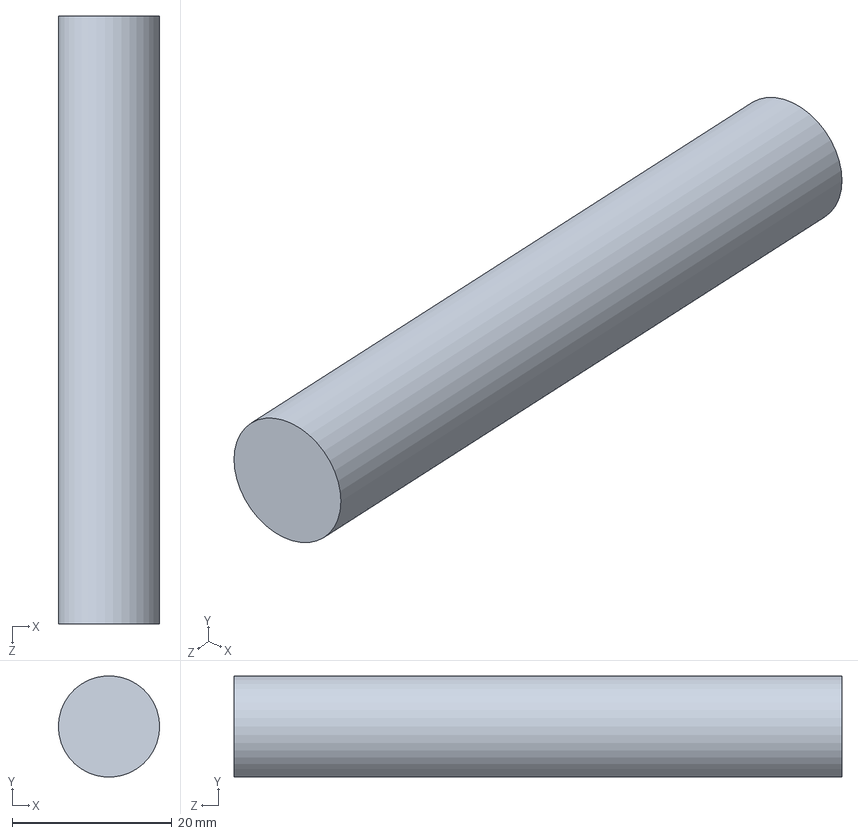
[picture p51: CAD file, 2025-07-08]
Fiber_Drawing_Tower/CAD_sketches/Capstan 2.0/Wheel shaft.SLDPRT
12.7 x 12.7 x 76.2 mm
