copl-labomc/fabconcept/Fiber_Drawing_Tower/CAD_sketches/Fiber tower structure (2023)/Piece_fixation.SLDPRT

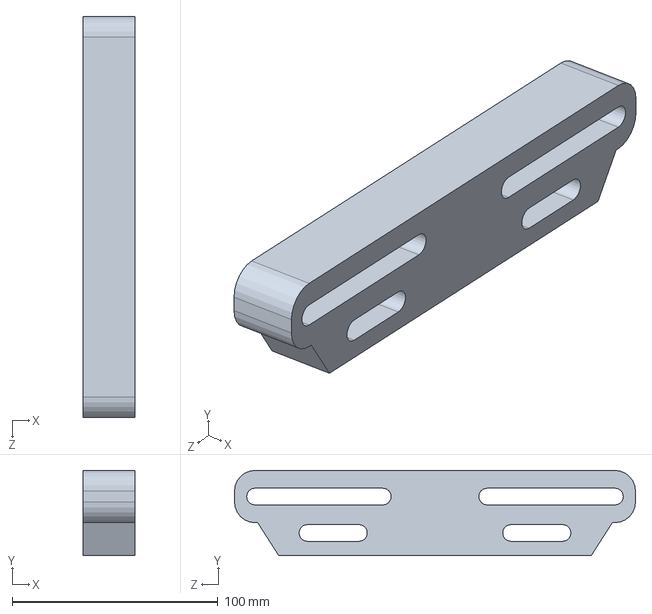
[picture p52: CAD file, 2024-05-07]
Fiber_Drawing_Tower/CAD_sketches/Fiber tower structure (2023)/Piece_fixation.SLDPRT
25.4 x 41.4 x 195.0 mm
