copl-labomc/fabconcept/Fiber_Drawing_Tower/CAD_sketches/Fiber tower structure (2023)/Pièce25.SLDPRT

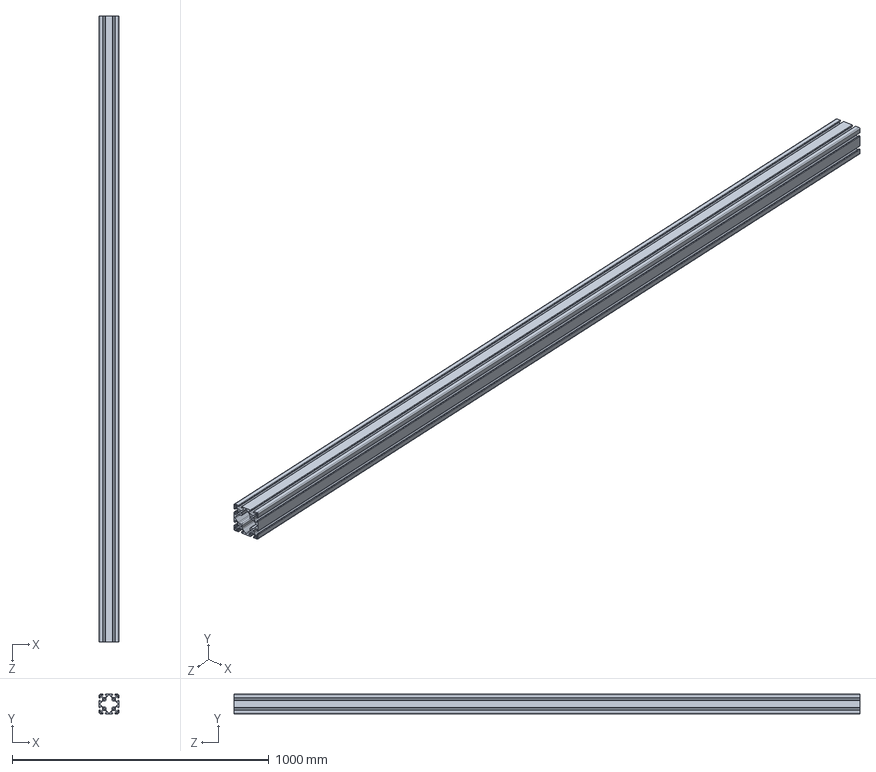
[picture p53: CAD file, 2024-05-07]
Fiber_Drawing_Tower/CAD_sketches/Fiber tower structure (2023)/Pièce25.SLDPRT
76.2 x 76.2 x 2438.4 mm
