copl-labomc/fabconcept/Fiber_Drawing_Tower/CAD_sketches/Fiber tower structure (2023)/Pièce24.SLDPRT

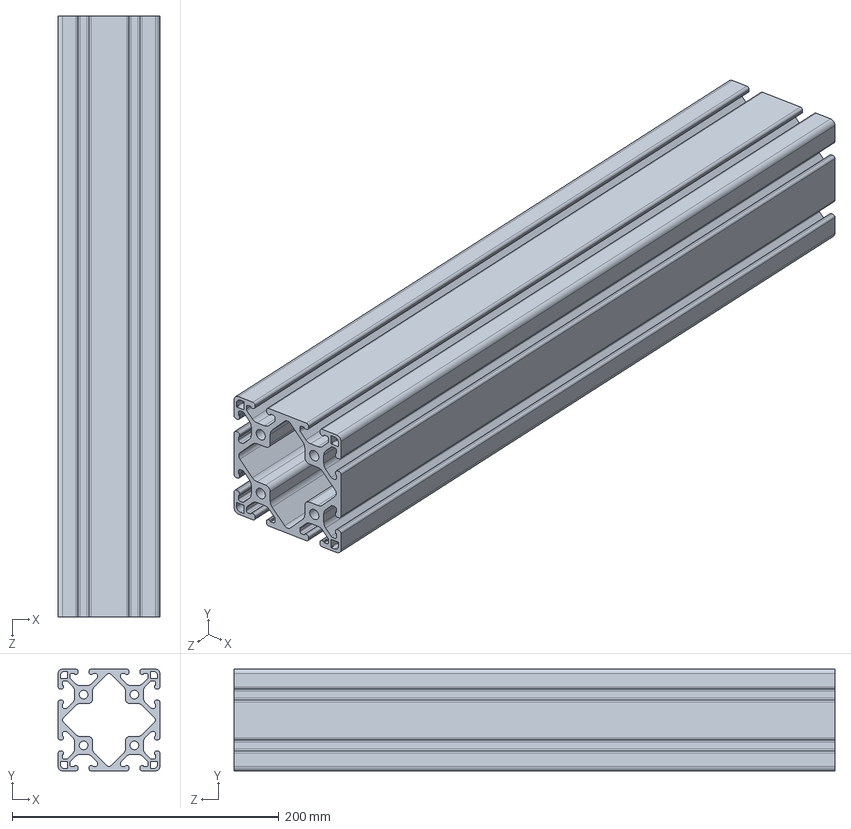
[picture p54: CAD file, 2024-05-07]
Fiber_Drawing_Tower/CAD_sketches/Fiber tower structure (2023)/Pièce24.SLDPRT
76.2 x 76.2 x 450.2 mm
