copl-labomc/fabconcept/Fiber_Drawing_Tower/CAD_sketches/Fiber tower structure (2023)/MB1830-Solidworks (1).sldprt

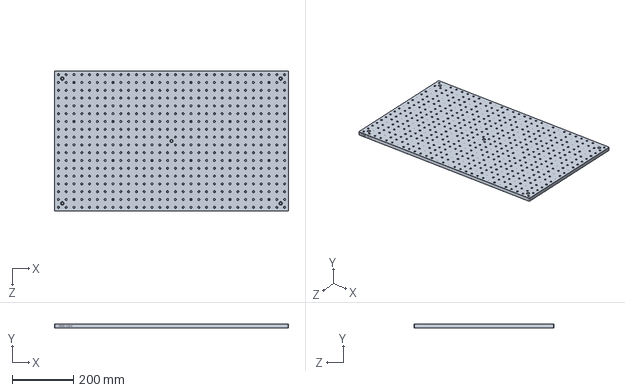
[picture p55: CAD file, 2024-05-07]
Fiber_Drawing_Tower/CAD_sketches/Fiber tower structure (2023)/MB1830-Solidworks (1).sldprt
762.0 x 12.7 x 457.2 mm
