copl-labomc/fabconcept/Fiber_Drawing_Tower/CAD_sketches/Fiber tower structure (2023)/bras_jauge.SLDPRT

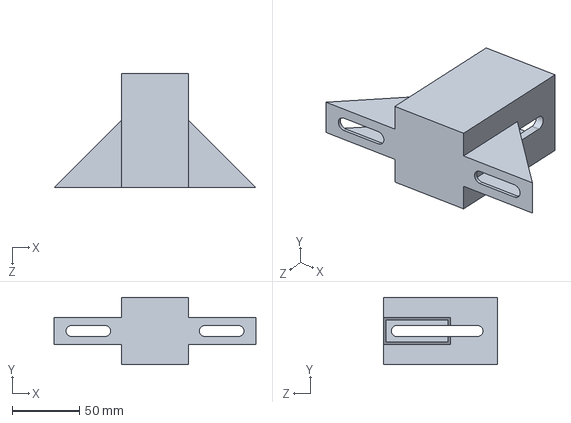
[picture p56: CAD file, 2024-05-07]
Fiber_Drawing_Tower/CAD_sketches/Fiber tower structure (2023)/bras_jauge.SLDPRT
150.0 x 50.0 x 85.0 mm
