copl-labomc/fabconcept/Fiber_Drawing_Tower/CAD_sketches/Fiber tower structure (2023)/Roue_1.SLDPRT

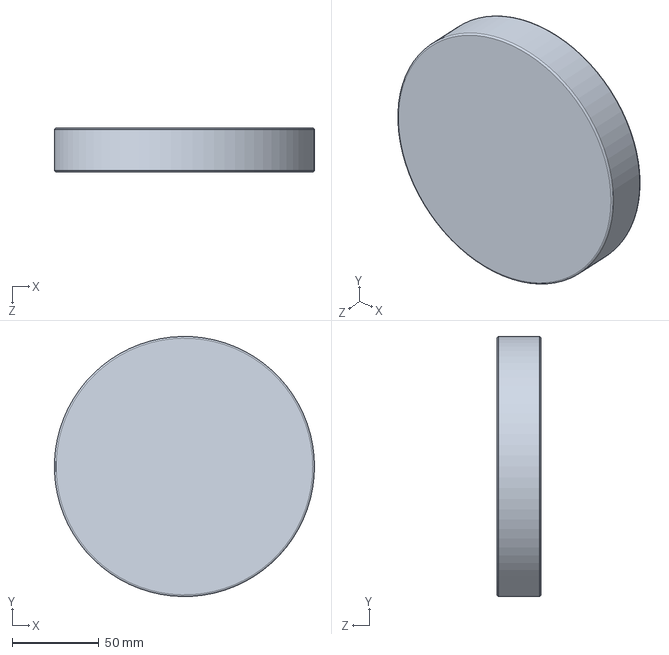
[picture p58: CAD file, 2024-05-07]
Fiber_Drawing_Tower/CAD_sketches/Fiber tower structure (2023)/Roue_1.SLDPRT
149.9 x 150.0 x 25.4 mm
