copl-labomc/fabconcept/Fiber_Drawing_Tower/CAD_sketches/Fiber tower structure (2023)/Pièce27.SLDPRT

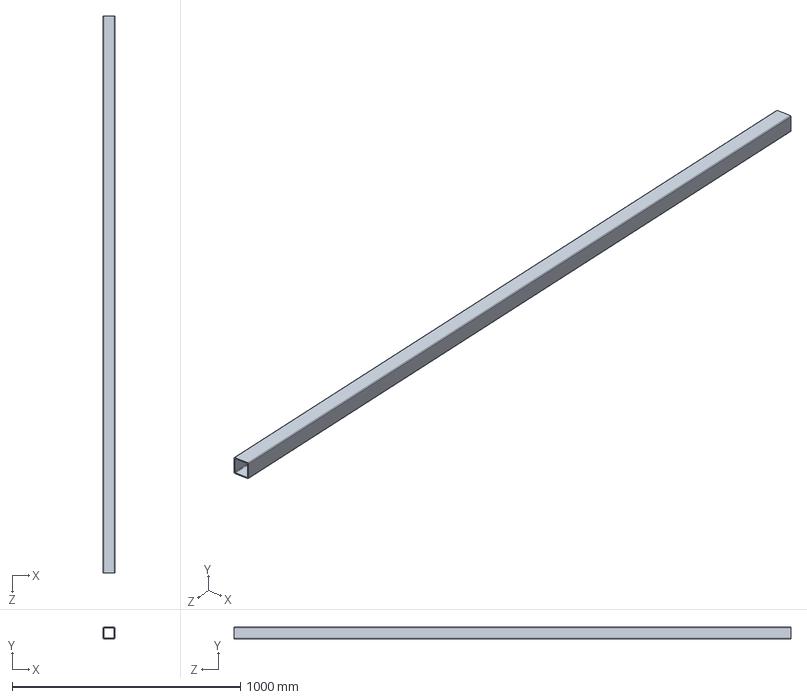
[picture p59: CAD file, 2024-05-07]
Fiber_Drawing_Tower/CAD_sketches/Fiber tower structure (2023)/Pièce27.SLDPRT
50.8 x 50.8 x 2438.4 mm
