copl-labomc/fabconcept/Fiber_Drawing_Tower/CAD_sketches/Fiber tower structure (2023)/Guide fibre.SLDPRT

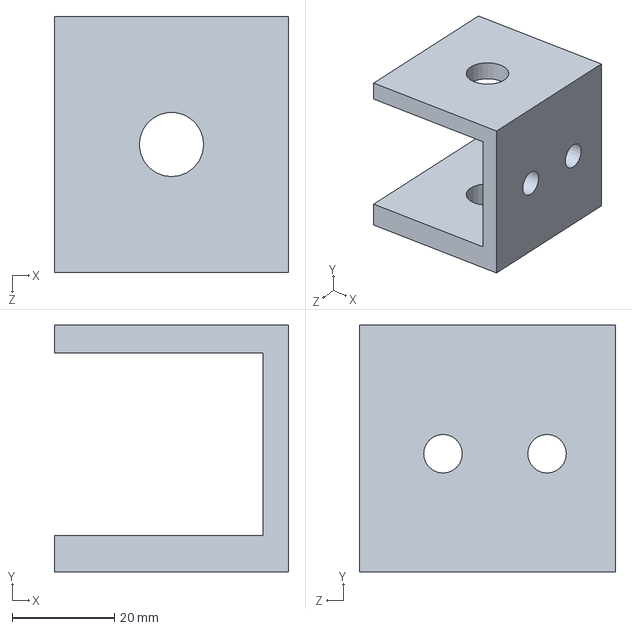
[picture p60: CAD file, 2024-05-07]
Fiber_Drawing_Tower/CAD_sketches/Fiber tower structure (2023)/Guide fibre.SLDPRT
45.8 x 48.2 x 50.0 mm
