copl-labomc/fabconcept/Fiber_Drawing_Tower/CAD_sketches/Fiber tower structure (2023)/Low-Carbon Steel Tube 32-1.SLDPRT

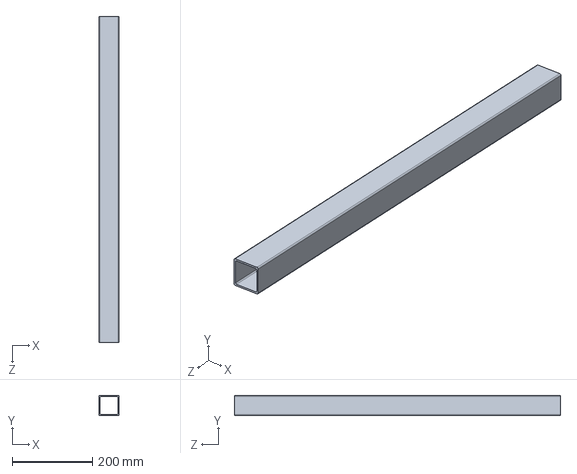
[picture p61: CAD file, 2024-05-07]
Fiber_Drawing_Tower/CAD_sketches/Fiber tower structure (2023)/Low-Carbon Steel Tube 32-1.SLDPRT
50.8 x 50.8 x 812.8 mm
