copl-labomc/fabconcept/Fiber_Drawing_Tower/CAD_sketches/Fiber tower structure (2023)/equerre.SLDPRT

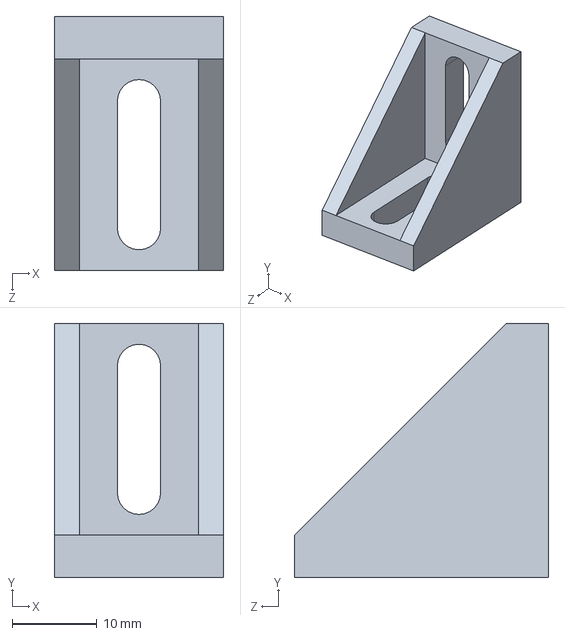
[picture p63: CAD file, 2024-05-07]
Fiber_Drawing_Tower/CAD_sketches/Fiber tower structure (2023)/equerre.SLDPRT
20.0 x 30.0 x 30.0 mm
