copl-labomc/fabconcept/Fiber_Drawing_Tower/CAD_sketches/holders laser sensor IG/holders.SLDASM

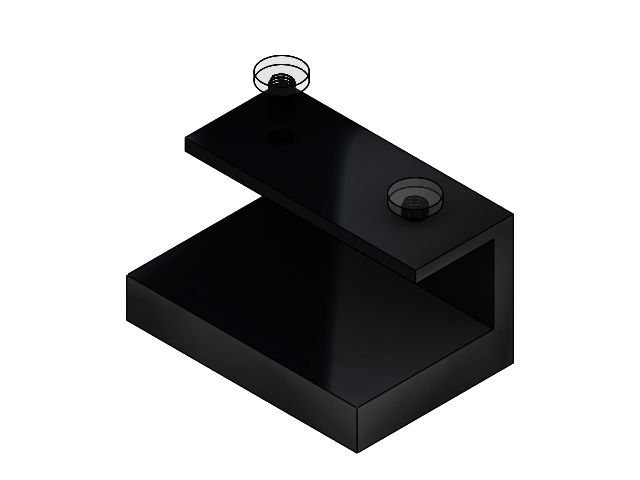
[picture p65: CAD file, 2024-05-31]
Fiber_Drawing_Tower/CAD_sketches/holders laser sensor IG/holders.SLDASM
holder
M4_screws x 2
