copl-labomc/fabconcept/Fiber_Drawing_Tower/CAD_sketches/holders laser sensor IG/Assemblage1.SLDASM

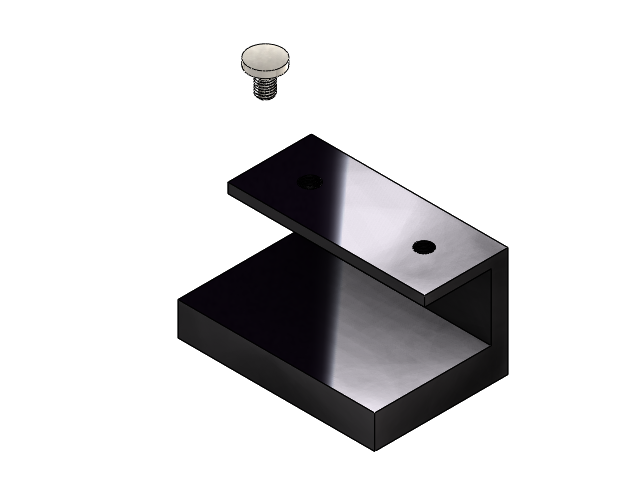
[picture p66: CAD file, 2024-05-31]
Fiber_Drawing_Tower/CAD_sketches/holders laser sensor IG/Assemblage1.SLDASM
holder
M4_screws
