copl-labomc/fabconcept/(list of files, cad)

Other CAD files:
Fiber_Drawing_Tower/CAD_sketches/Preform holder Didn't work/Base 1.SLDPRT
Fiber_Drawing_Tower/CAD_sketches/holders laser sensor IG/holder.SLDPRT
Fiber_Drawing_Tower/CAD_sketches/Capstan 2.0/Base other side.SLDPRT
Fiber_Drawing_Tower/CAD_sketches/Automatic spool/Current design/17HS19-1684S-PG5.SLDPRT
Fiber_Drawing_Tower/CAD_sketches/Automatic spool/Current design/coupleur 2 2.0.STL
Fiber_Drawing_Tower/CAD_sketches/Automatic spool/Current design/coupleur 1 2.0.STL
Fiber_Drawing_Tower/CAD_sketches/Capstan 2.0/Base motor side.SLDPRT
Fiber_Drawing_Tower/CAD_sketches/Fiber tower structure (2023)/Low-Carbon Steel Tube angle.sldprt
Fiber_Drawing_Tower/CAD_sketches/Fiber tower structure (2023)/MB30-Solidworks.sldprt
Fiber_Drawing_Tower/CAD_sketches/Fiber tower structure (2023)/Low-Carbon Steel Tube 32.sldprt
Fiber_Drawing_Tower/CAD_sketches/Fiber tower structure (2023)/Plaque de fixation.sldprt
Fiber_Drawing_Tower/CAD_sketches/Fiber tower structure (2023)/Low-Carbon Steel Tube 40.sldprt
Fiber_Drawing_Tower/CAD_sketches/Fiber tower structure (2023)/Low-Carbon Steel Tube 96.sldprt
Fiber_Drawing_Tower/CAD_sketches/Automatic spool/Current design/Fixation moteur.STL
Fiber_Drawing_Tower/CAD_sketches/Automatic spool/Old design/Bolt.SLDPRT
Fiber_Drawing_Tower/CAD_sketches/Automatic spool/Old design/Roly_pusher.SLDPRT
Fiber_Drawing_Tower/CAD_sketches/Automatic spool/Old design/Wing.SLDPRT
Fiber_Drawing_Tower/CAD_sketches/Automatic spool/Old design/thingymajig.SLDPRT
Fiber_Drawing_Tower/CAD_sketches/Capstan 2.0/3136N203_T-Slotted Framing.SLDPRT
Fiber_Drawing_Tower/CAD_sketches/Capstan 2.0/47065T239_Silver Corner Bracket.SLDPRT
Fiber_Drawing_Tower/CAD_sketches/Fiber tower structure (2023)/47065T277_T-Slotted Framing stock.sldprt
Fiber_Drawing_Tower/CAD_sketches/Fiber tower structure (2023)/47065T277_T-Slotted Framing.sldprt
Fiber_Drawing_Tower/CAD_sketches/Fiber tower structure (2023)/47065T602_T-Slotted Framing_36in.SLDPRT
Fiber_Drawing_Tower/CAD_sketches/Fiber tower structure (2023)/47065T608_ALUMINUM T-SLOTTED 17.725.sldprt
Fiber_Drawing_Tower/CAD_sketches/Fiber tower structure (2023)/47065T609_T-Slotted Framing.sldprt
Fiber_Drawing_Tower/CAD_sketches/Fiber tower structure (2023)/47065T942_T-Slotted Framing_30in.SLDPRT
Fiber_Drawing_Tower/CAD_sketches/Fiber tower structure (2023)/47065T942_T-Slotted Framing_slider.SLDPRT
Fiber_Drawing_Tower/CAD_sketches/Preform holder 2 Just a concept/Newport variable lens holder/Newport-LCM-1.stl
Fiber_Drawing_Tower/CAD_sketches/Preform holder Didn't work/Couvercle.STL
Fiber_Drawing_Tower/CAD_sketches/Preform holder Didn't work/Glisseur.STL
Fiber_Drawing_Tower/CAD_sketches/Preform holder Didn't work/SL_ST IRIS-01.STEP
Fiber_Drawing_Tower/CAD_sketches/Preform holder Didn't work/dent.STL
Fiber_Drawing_Tower/CAD_sketches/holders laser sensor IG/M4_screws.SLDPRT
Fiber_Drawing_Tower/CAD_sketches/holders laser sensor IG/MAPholder.SLDDRW
