copl-labomc/fabconcept/(threads)

Thread 10 (2024-05-10):

Design a PCB

alexmomo1212, 2024-05-10:
Design and fabricate a PCB for the tower's control circuit.

Ask the technical team if it can be done with Fritzing or has to be done with Altium.

cniallen, 2024-05-14:
I'm thinking we'll do a two-for-one on this one as it could be beneficial for teaching electronics as well, which means working on this with Steve at the VCH-0646.

Closed 2024-07-26.

Thread 12 (2024-05-10):

Change the Cabestan motor

alexmomo1212, 2024-05-10:
We need a new motor with lower torque and higher speed. Preferably, it should be from the same manufacturer so the size and shape is the same as the old one.

cniallen, 2024-05-14:
As the purchase order form is getting re-formatted, let @joycopl and me know if you select the model to order before I publish the new form to use. We'll order for you with the temporary one if needed.

joycopl, 2024-05-14:
The speed of the motor should be much higher than we have now. Check the similar motor with as much as possible higher speed. We will control the speed using potentiometer according to our requirements.

alexmomo1212, 2024-05-28:
The new motor has arrived all we need is to change the motor holder (Issue #31)

Closed 2024-05-28.

Thread 13 (2024-05-10):

Automate the spool

alexmomo1212, 2024-05-10:
Add a third motor and driver to automatically turn the spool. It has to pull the fiber at the same speed as the cabestan.

cniallen, 2024-05-14:
I'm not sure if it's with @grudule and/or @JOGAU227 that we looked into the motors I got from Coractive... Did one of them could do the job to turn the spool?

Or with a large enough spool, would the current cabestan motor have enough speed?

alexmomo1212, 2024-06-19:
Spool is automated

Closed 2024-06-19.

Thread 14 (2024-05-10):

Feedback loop for the diameter

alexmomo1212, 2024-05-10:
Eventually, have a PID system to control the motor speeds and keep the diameter constant.

alexmomo1212, 2024-06-20:
After speaking with Steve Morency, he recommends not using a closed loop system since it cannot correct the small deviations in the fiber's diameter. As long as the capstan speed is constant and the preform's diameter is uniform, the is no need for live adjustements.

Closed 2024-06-20.

Thread 15 (2024-05-10):

Align the fiber

alexmomo1212, 2024-05-10:
Align the fiber with the cabestan wheels and prevent it from slipping out.

alexmomo1212, 2024-07-26:
Works for now with a L metal piece stopping the fiber from moving. Could be upgraded further along the line.

Thread 17 (2024-05-10):

Organise the wires

alexmomo1212, 2024-05-10:
Self explanatory

alexmomo1212, 2024-05-31:
Contained within Issue PCB deisgn

Closed 2024-05-31.

Thread 18 (2024-05-10):

Casing/Box

alexmomo1212, 2024-05-10:
Put most of the components in some sort of casing so everything looks good. It would also reduce the risk of breaking something.

cniallen, 2024-05-14:
Think big picture once we work on this one : where to put each and every single loose and instrument and device directly on or besides the tower in such a way they are easy to read or access as needed.

alexmomo1212, 2024-08-21:
The order on the box is taking longer than expected and I won't be able do the box before the end of my internship. I leave it to the next person to finish cleaning up the electronics

Thread 8 (2024-05-10):

Secure the pump

alexmomo1212, 2024-05-10:
Secure the vacuum pump to the side of the fiber tower.

It must be able to reach the top preform as well as the working table.

cniallen, 2024-05-14:
Further reflexion makes me wonder if we won’t move the preform fabrication either to the 0308 or the 0775. I’m trying to keep the 0945 as clean as possible for our delicate optics. The fiber drawing tower is in the 0945 only because there is no space anywhere else in our labs to put it.
To be discussed…

Thread 9 (2024-05-10):

Circuit schematic

alexmomo1212, 2024-05-10:
Draw a circuit for the fiber tower's electronics.

It can be done with Fritzing, TinkerCAD or Altium.

cniallen, 2024-05-14:
We a strong preference for testing out Fritzing for educational purposes please.

cniallen, 2024-08-04:
I like the way the documentation is going, but I feel it's missing a little something to tie it together on the home-landing page. It's main theme should be "Welcome new fiber tower developper!" and, after redirecting a user to the "User guide" page with a link, give to the newcomer an overview that helps her or him get started in the advent everybody is too occupied to help right away. I guess it should be along the lines of what @grudule explained to @alexmomo1212 at the beginning of the summer.

I think it needs a section on how our workflow to work with github, small new features branches to be merged in the development branch first, test an executable, pull request to the main brach with code review and /fast-forward merge (assuming with fix he missing token!), etc. I think one of the first things @grudule did in the lab was a diagram for this workflow isn't it? I think it's worth putting it in that section.

I would also definitely bring the functional diagram on the homepage, is the original of that diagram in the repo somewhere btw? I think it needs a little updating and very much replacing "laser sensor" by "diameter sensor" please.

I think a section giving some info on the relations between the code and the circuit diagram would also help, since otherwise one as to dig in the code to figure out the ins and outs on the Arduino and drivers. Actually, those pins do not figure as some variables or arguments somewhere in the GUI_doc?

Thanks in advance for these improvements!

Thread 20 (2024-05-13):

Fix the alignement of the diameter gauge

alexmomo1212, 2024-05-13:

cniallen, 2024-05-14:
I was wondering if a spring loaded mechanism (bought from McMaster-Carr) wouldn’t be the best way to go… but than maybe less stable. Feel free to get advice from the mechanical workshop, their experience is much larger than all of ours combined on such things. I also wonder why Keyence didn’t provide some sort of fixation mechanism, you could write to them and ask if they have mounts already fitting the diameter gauge (not sure if it’s laser diodes or DELs btw) we could buy.

grudule, 2024-05-15:
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
I designed and 3D printed 2 of this holder who used springloaded Thorlabs screws. One is already in place the second is in the workshop !

Closed 2024-05-28.

Thread 21 (2024-05-14):

Organise and detail the wiki section ⬆️

cniallen, 2024-05-14:
The goal is to make the whole repo the easiest possible to navigate and understand for any newcomer in the lab. The tree command can help to produce an arborescence of the files as I mentioned on Slack.

cniallen, 2024-08-04:
I like the way the documentation is going, but I feel it's missing a little something to tie it together on the home-landing page. It's main theme should be "Welcome new fiber tower developper!" and, after redirecting a user to the "User guide" page with a link, give to the newcomer an overview that helps her or him get started in the advent everybody is too occupied to help right away. I guess it should be along the lines of what @grudule explained to @alexmomo1212 at the beginning of the summer.

I think it needs a section on how our workflow to work with github, small new features branches to be merged in the development branch first, test an executable, pull request to the main brach with code review and /fast-forward merge (assuming with fix he missing token!), etc. I think one of the first things @grudule did in the lab was a diagram for this workflow isn't it? I think it's worth putting it in that section.

I would also definitely bring the functional diagram on the homepage, is the original of that diagram in the repo somewhere btw? I think it needs a little updating and very much replacing "laser sensor" by "diameter sensor" please.

I think a section giving some info on the relations between the code and the circuit diagram would also help, since otherwise one as to dig in the code to figure out the ins and outs on the Arduino and drivers. Actually, those pins do not figure as some variables or arguments somewhere in the GUI_doc?

Thanks in advance for these improvements!

Thread 22 (2024-05-14):

Display the measured diameter in a real time graph on the GUI

cniallen, 2024-05-14:

cniallen, 2024-05-14:
I marked this as duplicate, since I realized it's probably the same thing Alexandre meant in issue #16
Feel free to close this is the case!

Closed 2024-05-15.

Thread 23 (2024-05-14):

Preform holder

joycopl, 2024-05-14:
New Preform holder should be capable to hold preform easily with variable preform diameter.

cniallen, 2024-05-14:
Good point, I was forgetting that one 👍 We should not have to design that whole holder from scratch, mechanical systems that hold drill bits (mandrin de Jacob in French, I don’t know the English name unfortunately) are in principle commercially available in all sorts of sizes. Again the team at the mechanical workshop can give good advices here, feel free to go see them anytime 😃

alexmomo1212, 2024-05-31:
Speak to the mechanical workshop to see if the have ideas/products.

Thread 26 (2024-05-16):

Change lead screw-motor  coupler

alexmomo1212, 2024-05-16:
This morning, I saw that this part was slipping. It could be upgraded with a little screw like on the cabestan wheel and a bit of threading to fit the screw.

alexmomo1212, 2024-07-09:
The part was changed to a prefessionnally made metal part

Closed 2024-07-09.

Thread 28 (2024-05-22):

Optimize serial communication

alexmomo1212, 2024-05-22:
The serial communication is too slow and affects the motors.

Closed 2024-05-23.

Thread 29 (2024-05-23):

Make sure the capstan wheels don't destroy the fiber

alexmomo1212, 2024-05-23:
The wheels either crush and destroy the fiber or it slips. We will have the find a fix if we ever wnat to automate the process

alexmomo1212, 2024-05-28:
We can wait until the spool is automated to work on this issue

alexmomo1212, 2024-06-20:
Closing this issue and combining with #31.

Thread 35 (2024-05-31):

Verify if the motors are heating

alexmomo1212, 2024-05-31:
If so, add a system that cuts their power after a certain time.

alexmomo1212, 2024-06-05:
I left the drivers on, with the new and old drivers. I will check this afternoon if they have heated

alexmomo1212, 2024-06-06:
Confirmed that the motors are overheating when left on

Closed 2024-06-06.

Thread 37 (2024-06-06):

Turn off power supply when idle

alexmomo1212, 2024-06-06:
Use a relay to switch on and off the power going to the motors to prevent overheating.

Could be used to turn on/off the furnace with the arduino

Closed 2024-08-07.

Thread 42 (2024-06-14):

Synchronize spool and preform motor

alexmomo1212, 2024-06-14:
Calculate and program the speed at which both motors need to spin so that the preform is lowered at the right speed. If this timing is wrong, the fiber could break or be eneven.

We need to measure the linear speed of the preform motor so Joy can do the calculations.

alexmomo1212, 2024-06-27:
Put the excel sheet for the calculations on the wiki

Closed 2024-07-26.

Thread 43 (2024-06-14):

Calibrate the diameter sensor analog reading

alexmomo1212, 2024-06-14:
The laser sensor sends an analog signal to the arduino but both devices currently show a different reading. We need to test multiple diamaters and do the appropriate conversions in code

alexmomo1212, 2024-06-19:
Fixed the problem. The solution was to connect the power supply's ground with the Arduino's ground. Since the two didn't have the same ground reference, the reading was off and unstable.

The offset is now adjusted to 0.02 mm and the reading on the GUI is now stable and identical to the reading on the sensor itself with a difference of 0.01 mm max.

Closed 2024-06-19.

Thread 50 (2024-07-10):

Replace screws on fiber injection translation stage

alexmomo1212, 2024-07-10:

alexmomo1212, 2024-07-22:
We would need to send it to repairs. However, it works alright as it is.

Closed 2024-07-22.

Thread 52 (2024-07-29):

Make a holder for the Telops camera

alexmomo1212, 2024-07-29:
It needs to be compatible with a standard camera stand adapter.

cniallen, 2024-07-30:
Thanks for adding the issue, would you mind writing and follow-up with Antoine to get the info to buy the camera holder he showed us and/or schematics of the thermal imaging camera itself please?

Thread 54 (2024-08-16):

Change the diameter visualisation to error

alexmomo1212, 2024-08-16:
The live diameter graph should display the difference between the given diameter command and the true measured diameter. Either that or possibly switch between the two modes.

Thread 55 (2024-08-16):

Independent ADC for diameter reading

alexmomo1212, 2024-08-16:
Have an analog to digital converter (ADC) that is independent from the Arduino. This is because the analog reading is currently affected by the state of the other pins. For instance, it wil give a different reading if the motors are on or off.
