copl-labomc/fabconcept/(list of files, drawings)

Other design files:
Fiber_Drawing_Tower/Electronics/Fiber_tower_circuit.fzz
