copl-labomc/fabconcept/(commit log)

2022-01-05 Create Arduino_control.py
    Designe génerale du controleur de l'arduino et quelque test
2022-01-11 Update Arduino_control.py
    Modification des input output
2022-02-05 Update Arduino_control.py
    Petit changement
2022-02-16 Travaille sur le code pour lire l'Arduino
    Fin du code pour permetre l'aquisition de donné sur l'Arduino et de créé un ficher CSV qui enregistre toute les valeur cumuler.
2022-02-26 Création de nouveau code
    Création du début du controleur PID pour l'asservicement du système et création du début d'un interface pour l'utilisation intuitive de la tour.
2022-03-09 Modification des codes
    Ajoute de class pour lees fonction de read du arduino et pour l'affichage du GUI
2022-03-10 Ajustement du code
    Travaille sur le GUI et le controleur de l'Arduino
2022-03-13 Modification des classe et esquisse du GUI
    [Concept_GUI.xlsx]
2022-03-16 Ajustement de quelque fonction
    Fonction .csv pour ajouter des donnés simplifié.
    Ajout de la liste de chose à fair pour finir la toure.
    [Concept_GUI.xlsx]
2022-03-17 Ajout de fonction sur le GUI
    [test_2022-03-17.csv]
2022-03-26 Ajustement du code
    Ajout de la fonction qui insert des donnés dans le fichier CSV
    [Concept_GUI.xlsx, test_2022-03-17.csv]
2023-06-05 Added folder for CAD files of tower parts
2023-06-08 PFE
    Ajout d'un folder (PFE_hiver_2023), qui contien le code utiliser pour controler l'arduino ainsi que le code qui controle la vitesse des uStepper
2023-06-19 Delete Arduino_control.py
    Has only 25 lines.
2024-02-15 correcting path for COM
    [GUI.py]
2024-03-21 new gui with arduino code pyserial
2024-03-27 adding stepper 2 and documentation
2024-04-03 fixed version of diameter due to mapping value in arduino
2024-04-03 minor change to print offset always
2024-04-17 cleaning and documentation for the merging request
    [Assemblage1.SLDASM, M4_screws.SLDPRT, MAPholder.SLDDRW, TS25H-Solidworks.SLDPRT, holder.SLDPRT, holders.SLDASM]
2024-04-17 remove printing
2024-05-07 Add files via upload (#4)
    Commit from Étienne Labbé 2023
    [47065T277_T-Slotted Framing stock.sldprt, 47065T277_T-Slotted Framing.sldprt, 47065T602_T-Slotted Framing_36in.SLDPRT, 47065T608_ALUMINUM T-SLOTTED 17.725.sldprt, 47065T609_T-Slotted Framing.sldprt, 47065T942_T-Slotted Framing_30in.SLDPRT, 47065T942_T-Slotted Framing_slider.SLDPRT, Assemblage V5.SLDASM]
2024-05-07 Draft : Develop (#5)
    merging V2 gui
    ---------
    [Assemblage1.SLDASM, Concept_GUI.xlsx, M4_screws.SLDPRT, MAPholder.SLDDRW, TS25H-Solidworks.SLDPRT, holder.SLDPRT, holders.SLDASM]
2024-05-13 holder for laser sensor
    [Assemblage1.SLDASM, MAPholder.SLDDRW, holder.SLDPRT, holder_3D_impression.STL, holders.SLDASM]
2024-05-22 Drop-down menu for connection + motor fix (#25)
    * Draft : Develop (#5)
    * Début readme et corrections mineures
    * Debug screen and sending float
    * Automatic port detection
    * Port connnection menu on GUI
    * Code rearanging
    * Reconnection button
    * Already connected check
    * Status change
    * Check ports button
    * check if connected before ser.write()
    * status label color
    * bug fix
    * Set baudrate to 57600
    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
    [Concept_GUI.xlsx]
2024-05-27 motor fix 2
2024-05-29 Comments in arduino code
2024-05-31 Port selection and motor fix (#30)
    * testing
    * initial
    * initial commit
    * executable V1
    * correcting path for COM
    * executable V2
    * patching V2
    * patched V2
    * error du to new python version
    * new gui with arduino code pyserial
    * adding stepper 2 and documentation
    * correcting comment code
    * max speed to 1000 instead of 5000
    * minor fix for speed at 0
    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
    [Assemblage1.SLDASM, Concept_GUI.xlsx, MAPholder.SLDDRW, holder.SLDPRT, holder_3D_impression.STL, holders.SLDASM]
2024-06-05 13 automate the spool (#36)
    * changed cabestan to capstan
    * spool arduino code
    * spool buttons and bug fix
    [GUI.py, fiber_tower_control.ino]
2024-06-12 33 code refactoring (#38)
    * class init
    * optimize command function
    * working class
    * connection no longer wip
    * stabilize gui
    * removed tkinter inheritance to simplify auto docsting
    * documentation for class
    * gui jittering fix
    * done refactoring
    * removed pydoc test
    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
    [GUI.py, fiber_tower_control.ino]
2024-06-12 Finalising the spool (#40)
    * reverse reverses in reverse
    * exectuable
    [fiber_tower_control.ino]
2024-06-17 Record diameter in a file (#45)
    * data structure
    * Save data to dictionnary
    * saving wip
    * Save file with date and time as file name
    * Created Frawing_data folder
    * simplified imports
    * branch update
    * folder disappeared
    * dummy text file so the folder is commited
    * Commented out instructions for unused capstan in arduino code
    * Removed capstan gui elements
    * GUI and DEBUG executables
    * deleted exectuable to fix merge
    * new executable
    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
    [GUI.py, fiber_tower_control.ino]
2024-06-21 43 calibrate the diameter sensor analog reading (#46)
    * Average of 10 diameter measurements
    * changed offset to 0.02
2025-07-07 Capstan is back 2.0 (#53)
    * Readded capstan functionnality to arduino code
    * dumb bug fix
    * config file
    * send config to arduino
    * automatic mode
    * tidying
    * lots of stuff
    * time and length
    * exécutable
    * bug fixing
    [GUI.py, fiber_tower_control.ino]
2025-07-07 solidworks files
    [17HS19-1684S-PG5.SLDPRT, 3136N203_T-Slotted Framing.SLDPRT, 47065T239_Silver Corner Bracket.SLDPRT, 47065T277_T-Slotted Framing stock.sldprt, 47065T277_T-Slotted Framing.sldprt, 47065T602_T-Slotted Framing_36in.SLDPRT, 47065T608_ALUMINUM T-SLOTTED 17.725.sldprt, 47065T609_T-Slotted Framing.sldprt]
2025-07-07 arduino documentation
2025-07-07 relay protection timer
2025-07-07 Live diameter visualisation (#56)
    * Working visualisation
    * debug screen
    * electronics dircuit diagram
    * record function cleanup
    * progress bar explanation
    * checkSerialPort cleanup
    * changed schematic from pdf to png
    [Fiber_tower_circuit.fzz]
2025-07-07 M_PI on arduino
2025-07-07 preview button and fix
    [GUI.py]
